Yuna-Celisse/light-control/docs/review-2026-11-10.md

# 2026-11-10 设计变更记录

以下为主控迁移前的历史 PCB 复核。此后用户要求清空全部布线与过孔，已保存并回读确认走线 0、过孔 0。历史 DRC 零违规结果对应此前板文件。当前原理图已迁移 STM32F103C8T6，PCB 已完成同步，待重新布线。

## PCB 同步与 SWD 焊盘

2026-11-10 将最新原理图同步至 PCB，按用户要求尽量保留原布局，并将 SWD 接口改为表面焊接焊盘。保存板含 164 个器件、102 个网络、3 个铺铜区，走线和过孔均为 0。

### 布局变更

155 个原器件的位置、角度和层逐项回读一致。U5 替换为 LQFP48，中心沿用 (90, 72) mm，角度设为 270°。删除 L2、L3、C36 及其残留丝印。Y1 回灌标准封装并沿用原位置与角度。为消除新主控封装碰撞，微调以下外围器件。

|器件|原位置 mm|最终位置 mm|
|---|---|---|
|R9|(84, 73.5)|(83.4, 73.5)|
|R12|(84, 75)|(83.4, 75)|
|C16|(93.5, 66.5)|(93.5, 64)|
|C17|(88.5, 77.5)|(88.5, 78.5)|
|C35|(95, 72)|(96.5, 72)|
|R36|(91.2, 77.5)|(91.2, 78.5)|
|R37|(92.4, 77.5)|(92.4, 78.5)|

J2 使用工程内封装 `Lights_Edge:SWD_SolderPads_1x06_P2.00mm`。六个焊盘位于正面，单焊盘 1.5 × 2 mm、中心间距 2 mm，焊盘 1 位于 (62, 64) mm，其余向右递增。只含 F.Cu 与 F.Mask，SWD 钻孔数为 0。正面从左至右为 3V3、SWDIO、GND、SWCLK、NRST、GND，已添加信号丝印和 pin 1 标记。

新焊盘通过 MCP 创建，已查询库内几何、导出并查看临时原理图及 PCB，核对编号方向、尺寸与零钻孔后用于工程。原理图的 J2 封装、器件值与 Y1 采购型号字段已同步。变更通过 Konnect MCP 与用户已允许的 KiCad 原生 IPC 完成。

### 最终验证

- 根原理图层级同步预检为 `noop`，零变更、零冲突，覆盖 11 张在用原理图。
- 实时 IPC 核对 164 个器件的引用、数值、封装一致，全部原理图引脚均有 PCB 焊盘，焊盘网络差异为 0。
- SWD 实例为 6 个 SMD 焊盘，钻孔尺寸均为 0。
- 重填铺铜、保存后运行 KiCad 10.0.8 DRC。253 项错误均为未布线连接，8 项警告包括 6 项 `lib_footprint_mismatch`、1 项 Y1 的 `C0 max` 字段差异、1 项 In1.Cu 地铜孤岛。
- 短路、铜间距、阻焊桥、封装碰撞、PTH 穿入封装及丝印违规均为 0。
- 原理图 ERC 为 0 个错误、27 个库符号差异警告。
- 布局评分为 85，圆角板框使该工具返回 `outline_unproven`，完整布局就绪结论仍缺该工具的包含性证明。

同步期间编辑器两次退出，已从保存检查点恢复并重新核对最终器件、网络和位置。原生 IPC 新增晶振自定义字段触发退出，PCB 的 `C0 max` 字段差异保留在报告中。Y1 的完整采购型号已写入原理图 MPN 与 PCB 器件值。当前板待重新布线。

检查报告与源文件哈希已更新。部分标准库仍使用本机其他工程的绝对路径。

## 原理图模块连线整理

2026-11-10 完成 11 张在用原理图整理。模块内部的电阻、电容、IC 与反馈回路改为连续导线，模块之间通过网络标签连接。电源与地使用电源符号，内部网名在需要说明节点时标注于连续导线上。

- 顶层 USB、VBUS 与主控之间长线改为接口标签。
- STM32 的复位、启动、晶振、USB 串联电阻与上拉、供电去耦改为直接连线，调试、按键与指示灯按功能分组。
- USB 插座到 ESD、CC 下拉和屏蔽 RC 直接连线。
- ADC 输入滤波、上拉电阻与供电去耦直接接入对应引脚支路。
- 双光谱模块的电平转换偏置、上拉、中断与去耦整理为连续电路。
- 双 TIA 与双恒流驱动的反馈电阻、补偿电容和 MOS 管直接连成闭环，参考电源与关断控制按功能成组。

独立导出网表核对了全部 164 个器件的型号、数值、封装、UUID 与层级路径，结果一致。整理前后 102 组网络端点集合一致，新增与删除的连接集合均为 0。逐页导线检查均为 0 个悬空端点，短路、孤立项、连接与层级端口检查均为 0 项。已查看全部在用页最终渲染图，并修正重叠标注与残留孤立连接点。

KiCad 10.0.8 独立 CLI ERC 为 0 个错误、27 个既有库符号差异警告，报告与源文件哈希已更新。当前检查对应此次整理后的原理图。

## STM32 原理图迁移

已将主控替换为 STM32F103C8T6，根页改为引用 `03_stm32f103.kicad_sch`。旧 ESP32 子页作为未引用历史文件保留。双 AS7341 承担系统中的其他检测用途，保留其 1.8 V 供电、PCA9306 与中断电平转换，同时保留 ADS1115、双 TIA、双波长驱动和 USB。

- 移除 ESP32 专用 L2、L3、C36，新增 J2 SWD 接口，复用其他外围器件。
- 补齐三组 VDD 100 nF、10 µF 总旁路、VBAT 100 nF、VDDA 100 nF 与 1 µF。
- NRST 使用 10 kΩ 上拉与 100 nF，BOOT0 与 BOOT1 下拉，BOOT 按键拉高 BOOT0。
- USB 使用 PA11/PA12、22 Ω 串联电阻和 MCU 侧 D+ 1.5 kΩ 上拉。
- PB6/PB7 连接 ADS1115 与左 AS7341，PB10/PB11 连接右 AS7341。中断使用不同 EXTI 编号。
- 选择 ABM8W-12.0000MHZ-6-D1X-T3，HSE 12 MHz、PLL ×6、USB 分频 1.5。C38/C39 初配 6 pF，寄生暂按 3 pF 估计，实际负载、驱动功率与起振须在最终 PCB 上验证。

### 当前验证

KiCad 10.0.8 独立 CLI ERC 覆盖 11 张在用原理图，结果为 0 个错误、27 个警告，全部为 `lib_symbol_mismatch`。MCP 更新库符号后仍返回未变更，这些差异告警保留，详细结果位于 `docs/checks/erc.json`。

导出网表为 164 个器件。独立检查确认 U5 的 VBAT、VDDA、三个 VDD 与四个地引脚连接正确，USB 上拉在 MCU 侧，两组 I²C 端点正确。迁移前后比较主控块以外全部端点的连接集合，业务模块间连接一致。主控连接、短路、孤立项、重叠与层级端口检查均为 0 项，已查看主控页和根页渲染图。

新注册的部分标准符号与封装库仍引用 `/home/yunacelisse/rocos-transmitter/rocos-transmitter/libraries/` 的本机绝对路径，迁移环境时需要配置相应标准库。源文件哈希已更新。`docs/checks/drc.json` 已更新为当前 PCB 检查结果，后续布线完成后需再次验证。

### 原厂依据

- 主控供电、引脚、USB 与 HSE 参数见 [ST STM32F103x8/xB 数据手册](https://www.st.com/resource/en/datasheet/stm32f103c8.pdf)。
- 主控外围设计见 [ST AN2586 硬件开发指南](https://www.st.com/resource/en/application_note/an2586-getting-started-with-stm32f10xxx-hardware-development-stmicroelectronics.pdf)。
- 晶振电气参数与焊盘定义见 [Abracon ABM8W 数据手册](https://abracon.com/datasheets/ABM8W.pdf)。

## 历史 PCB 复核

2026-11-10，目标为工作区 light-control.kicad_pcb，裸芯片 ESP32-S3FN8 四层板。全部源设计变更经 Konnect MCP 实时 IPC 完成。本记录描述已保存源文件。

## 已完成修复

1. 晶振 Y1 下方的 In2.Cu VBUS_DET 原斜线穿过晶振投影，已改为沿晶振上方与左侧绕行。时钟输入输出保持顶层，无新增时钟过孔。首次候选产生的铜冲突已在后续迭代消除。EN_760、EN_850 精确线段几何复核后未穿过晶振本体，恢复原路径。
2. U2 降压电源 C6 100nF 的 VIN 支路由经 C5 焊盘绕行改为直接到 U2 VIN。新支路使用 0.3mm 线宽。电容位置保持原坐标。
3. U101短距TIA输出反馈支路已缩短，增加两颗过孔，负输入节点保持原状。
4. 经 IPC 重填全部铺铜，再保存。随后以保存文件运行完整 KiCad DRC。

## 模块检查

|模块|本次证据与判断|
|---|---|
|晶振与ESP32|修复本体下方VBUS_DET。晶振40MHz、负载电容两颗15pF，标称CL10pF，精确负载和频偏仍须结合具体晶体MPN、寄生及实测。芯片与晶振间距应按乐鑫裸芯片指南处理。|
|降压电源|SW顶层三段0.5mm，总长约3.02mm。FB位于另一侧。缩短C6高频供电支路，输入输出环路仍需实测纹波和负载瞬态。|
|1.8V与光谱传感器|检查相关IC与电容现有位置、供电连接。自动审查中跨页电源缺电容的告警须结合整个层次网表判断。|
|USB与ESD|顶层主干0.25mm线宽、0.4mm中心距，主体成对经过USBLC6。90Ω差分阻抗仍缺板厂实际叠层验证。|
|ADS1115|VDD到C22正端直线约2.4mm。检查了器件位置和网络。有效精度、输入滤波带宽仍需实测验证。|
|双路TIA|U101/C105、U102/C110电源引脚到100nF正端均约1.7mm。U101输出反馈绕行约14mm，显著优化涉及局部反馈/参考/接地协调处理。已通过两颗0.6/0.3mm过孔，让低阻输出侧在In2.Cu回接R102，三段0.2mm走线合计5.754mm。负输入SUM保持原布局和走线。最终DRC零违规。|
|LED驱动与参考电源|执行全层次ERC和聚合连接、电源审查，相关模拟性能、驱动电流及温升尚无实测证据。|
|板框与装配|DRC无板框或courtyard错误。布局评分器对圆角板框返回outline_unproven，100分不能作为完整通过证据。R39与U102分处正反面，不能用二维中心距离直接判定同面装配冲突。|

## 验证结果

- 实时IPC板信息确认4层、115网络、166器件。查询并保存最终走线证据 本次 IPC 回读记录（本地）。
- checks/drc.json 为铺铜实时重填并保存后的KiCad检查，0 errors、0 warnings、0 unconnected、0 schematic parity。
- checks/erc.json，KiCad 10.0.7，0 errors、0 warnings。
- 本地聚合复核报告覆盖11个原理图文件、11个sheet实例。聚合报告的电源告警含跨页遗漏与将VBUS_DET检测信号当电源的启发式项，未盲目增加器件。
- 自动检查与当前几何证据不足以证明噪声、晶振起振裕量、USB阻抗及实板性能满足指标。整体电气设计审查仍有待完成项。

## 原厂依据

- https://docs.espressif.com/projects/esp-hardware-design-guidelines/en/latest/esp32s3/pcb-layout-design.html
- https://www.ti.com/lit/ds/symlink/tlv62568.pdf
- https://www.ti.com/lit/ds/symlink/tlv9061.pdf

## 界面差异与后续任务

用户随后提供的编辑器截图显示1467条走线与166个过孔。再次IPC回读得到1470条走线，保存文件中有168个过孔与U101新增输出反馈路径。重绘尝试后截图仍未更新，显示差异原因尚未确定。晶振周围器件位置未作调整，布局和地隔离审查仍需继续。

本次发布前对保存文件重新检查，DRC与ERC均零错误、零警告。
