Yuna-Celisse/light-control/BOM/20261029/light-control-BOM-detail.csv

Reference | Value | Footprint | Quantity | Manufacturer | MPN | Tolerance | Dielectric | ProcurementStatus | Datasheet | DNP | ExcludeFromBOM | ExcludeFromBoard
C1 | 1uF_16V | Capacitor_SMD:C_0603_1608Metric | 1
C2 | 0.1uF | Capacitor_SMD:C_0402_1005Metric | 1
C3 | 10nF | Capacitor_SMD:C_0402_1005Metric | 1
C4 | 10nF | Capacitor_SMD:C_0603_1608Metric | 1
C5 | 4.7uF_16V | Capacitor_SMD:C_0805_2012Metric | 1
C6 | 0.1uF | Capacitor_SMD:C_0402_1005Metric | 1
C7 | 22uF_10V | Capacitor_SMD:C_0805_2012Metric | 1
C8 | 0.1uF | Capacitor_SMD:C_0402_1005Metric | 1
C9 | 1uF | Capacitor_SMD:C_0402_1005Metric | 1
C10 | 2.2uF | Capacitor_SMD:C_0603_1608Metric | 1
C11 | 0.1uF | Capacitor_SMD:C_0402_1005Metric | 1
C12 | 1uF_16V | Capacitor_SMD:C_0402_1005Metric | 1
C14 | 4.7uF | Capacitor_SMD:C_0603_1608Metric | 1
C15 | 10uF | Capacitor_SMD:C_0805_2012Metric | 1
C16 | 100nF | Capacitor_SMD:C_0402_1005Metric | 1
C17 | 100nF | Capacitor_SMD:C_0402_1005Metric | 1
C18 | 1uF | Capacitor_SMD:C_0402_1005Metric | 1
C19 | 1nF | Capacitor_SMD:C_0402_1005Metric | 1
C20 | 1nF | Capacitor_SMD:C_0402_1005Metric | 1
C21 | 1nF | Capacitor_SMD:C_0402_1005Metric | 1
C22 | 0.1uF | Capacitor_SMD:C_0402_1005Metric | 1
C23 | 10uF | Capacitor_SMD:C_0805_2012Metric | 1
C24 | 0.1uF | Capacitor_SMD:C_0402_1005Metric | 1
C25 | 0.1uF | Capacitor_SMD:C_0402_1005Metric | 1
C26 | 1uF | Capacitor_SMD:C_0402_1005Metric | 1
C27 | 0.1uF | Capacitor_SMD:C_0402_1005Metric | 1
C28 | 0.1uF | Capacitor_SMD:C_0402_1005Metric | 1
C29 | 0.1uF | Capacitor_SMD:C_0402_1005Metric | 1
C30 | 1uF | Capacitor_SMD:C_0402_1005Metric | 1
C31 | 0.1uF | Capacitor_SMD:C_0402_1005Metric | 1
C32 | 6.8pF | Capacitor_SMD:C_0402_1005Metric | 1 |  |  | 5% | C0G
C33 | 100nF | Capacitor_SMD:C_0402_1005Metric | 1
C34 | 1uF | Capacitor_SMD:C_0402_1005Metric | 1
C35 | 100nF | Capacitor_SMD:C_0402_1005Metric | 1
C36 | 1uF | Capacitor_SMD:C_0402_1005Metric | 1
C37 | 100nF | Capacitor_SMD:C_0402_1005Metric | 1
C38 | 15pF C0G | Capacitor_SMD:C_0402_1005Metric | 1
C39 | 15pF C0G | Capacitor_SMD:C_0402_1005Metric | 1
C101 | 10uF | Capacitor_SMD:C_0805_2012Metric | 1 |  | CL21A106KAYNNNE
C102 | 10pF | Capacitor_SMD:C_0603_1608Metric | 1 | SAMSUNG(三星) | CL10C100JB8NNNC
C103 | 10uF | Capacitor_SMD:C_0805_2012Metric | 1 |  | CL21A106KAYNNNE
C104 | 1uF | Capacitor_SMD:C_0603_1608Metric | 1 | SAMSUNG(三星) | CL10A105KB8NNNC
C105 | 100nF | Capacitor_SMD:C_0603_1608Metric | 1 | YAGEO(国巨) | CC0603KRX7R9BB104
C106 | 10nF | Capacitor_SMD:C_0603_1608Metric | 1 | FH(风华) | 0603B103K500NT
C107 | 1.5pF | Capacitor_SMD:C_0603_1608Metric | 1 | SAMSUNG(三星) | CL10C1R5BB8NNNC
C108 | 10uF | Capacitor_SMD:C_0805_2012Metric | 1 |  | CL21A106KAYNNNE
C109 | 1uF | Capacitor_SMD:C_0603_1608Metric | 1 | SAMSUNG(三星) | CL10A105KB8NNNC
C110 | 100nF | Capacitor_SMD:C_0603_1608Metric | 1 | YAGEO(国巨) | CC0603KRX7R9BB104
C111 | 10nF | Capacitor_SMD:C_0603_1608Metric | 1 | FH(风华) | 0603B103K500NT
C112 | 10uF | Capacitor_SMD:C_0805_2012Metric | 1 |  | CL21A106KAYNNNE
C113 | 10uF | Capacitor_SMD:C_0805_2012Metric | 1 |  | CL21A106KAYNNNE
C114 | 1uF | Capacitor_SMD:C_0603_1608Metric | 1 | SAMSUNG(三星) | CL10A105KB8NNNC
C115 | 100nF | Capacitor_SMD:C_0603_1608Metric | 1 | SAMSUNG(三星) | CL10B104KB8NNNC
C116 | 1nF | Capacitor_SMD:C_0603_1608Metric | 1 | SAMSUNG(三星) | CL10C102JB8NNNC
C117 | 1nF | Capacitor_SMD:C_0603_1608Metric | 1 | SAMSUNG(三星) | CL10C102JB8NNNC
C118 | 100nF | Capacitor_SMD:C_0603_1608Metric | 1
C119 | 1uF | Capacitor_SMD:C_0603_1608Metric | 1
D1 | LED_STATE | LED_SMD:LED_0603_1608Metric | 1
D101 | 760-770nm | FNIRS:JNJ_760_3535_3P | 1 | JNJOPTO(强生光电) | JNJ-LEHR0113W120/42MIL/760-770NM
D102 | VBPW34S | FNIRS:VBPW34S_Normal_Gullwing | 1 | VISHAY(威世) | VBPW34S
D103 | VBPW34S | FNIRS:VBPW34S_Normal_Gullwing | 1 | VISHAY(威世) | VBPW34S
D104 | 850nm | FNIRS:JNJ_850_3036_2P | 1 | JNJOPTO(强生光电) | JNJ-LTJI0106W90/14mil-D/850NM
H1 | M3_NPTH_3.2mm | Lights_Edge:MountingHole_M3_3.2mm_Clearance7mm | 1
H2 | M3_NPTH_3.2mm | Lights_Edge:MountingHole_M3_3.2mm_Clearance7mm | 1
H3 | M3_NPTH_3.2mm | Lights_Edge:MountingHole_M3_3.2mm_Clearance7mm | 1
H4 | M3_NPTH_3.2mm | Lights_Edge:MountingHole_M3_3.2mm_Clearance7mm | 1
J1 | USB-C_16P | Lights_Edge:USB_C_Receptacle_HRO_TYPE-C-31-M-12 | 1 |  |  |  |  |  | https://www.usb.org/sites/default/files/documents/usb_type-c.zip
L1 | XAL4020-222MEC | Inductor_SMD:L_Coilcraft_XAL4020-XXX | 1
L2 | 2nH 600mA | Inductor_SMD:L_0402_1005Metric | 1
L3 | 24nH | Inductor_SMD:L_0402_1005Metric | 1
Q1 | DMN2056U-7 | Package_TO_SOT_SMD:SOT-23 | 1 | Diodes Incorporated | DMN2056U-7 |  |  |  | https://www.diodes.com/assets/Datasheets/DMN2056U.pdf
Q2 | DMN2056U-7 | Package_TO_SOT_SMD:SOT-23 | 1 | Diodes Incorporated | DMN2056U-7 |  |  |  | https://www.diodes.com/assets/Datasheets/DMN2056U.pdf
Q3 | DMN2056U-7 | Package_TO_SOT_SMD:SOT-23 | 1 | Diodes Incorporated | DMN2056U-7 |  |  |  | https://www.diodes.com/assets/Datasheets/DMN2056U.pdf
Q4 | DMN2056U-7 | Package_TO_SOT_SMD:SOT-23 | 1 | Diodes Incorporated | DMN2056U-7 |  |  |  | https://www.diodes.com/assets/Datasheets/DMN2056U.pdf
Q101 | AO3400A | Package_TO_SOT_SMD:SOT-23 | 1 | Alpha and Omega Semiconductor | AO3400A |  |  |  | http://www.aosmd.com/pdfs/datasheet/AO3400A.pdf
Q102 | AO3400A | Package_TO_SOT_SMD:SOT-23 | 1 | Alpha and Omega Semiconductor | AO3400A |  |  |  | http://www.aosmd.com/pdfs/datasheet/AO3400A.pdf
Q103 | 2N7002 | Package_TO_SOT_SMD:SOT-23 | 1 | Vishay | 2N7002 |  |  |  | https://www.onsemi.com/pub/Collateral/NDS7002A-D.PDF
Q104 | 2N7002 | Package_TO_SOT_SMD:SOT-23 | 1 | Vishay | 2N7002 |  |  |  | https://www.onsemi.com/pub/Collateral/NDS7002A-D.PDF
R1 | 5.1k | Resistor_SMD:R_0402_1005Metric | 1
R2 | 5.1k | Resistor_SMD:R_0402_1005Metric | 1
R3 | 100k | Resistor_SMD:R_0402_1005Metric | 1
R4 | 150k | Resistor_SMD:R_0402_1005Metric | 1
R5 | 1M | Resistor_SMD:R_0603_1608Metric | 1
R6 | 453k | Resistor_SMD:R_0402_1005Metric | 1
R7 | 100k | Resistor_SMD:R_0402_1005Metric | 1
R8 | 100k | Resistor_SMD:R_0402_1005Metric | 1
R9 | 10k | Resistor_SMD:R_0402_1005Metric | 1
R10 | 1k | Resistor_SMD:R_0402_1005Metric | 1
R11 | 10k | Resistor_SMD:R_0402_1005Metric | 1
R12 | 10k | Resistor_SMD:R_0402_1005Metric | 1
R13 | 100k | Resistor_SMD:R_0402_1005Metric | 1
R14 | 100k | Resistor_SMD:R_0402_1005Metric | 1
R15 | 100 | Resistor_SMD:R_0402_1005Metric | 1
R16 | 100 | Resistor_SMD:R_0402_1005Metric | 1
R17 | 100 | Resistor_SMD:R_0402_1005Metric | 1
R18 | 10k | Resistor_SMD:R_0402_1005Metric | 1
R19 | 4.7k | Resistor_SMD:R_0402_1005Metric | 1
R20 | 4.7k | Resistor_SMD:R_0402_1005Metric | 1
R21 | 4.7k | Resistor_SMD:R_0402_1005Metric | 1
R22 | 4.7k | Resistor_SMD:R_0402_1005Metric | 1
R23 | 4.7k | Resistor_SMD:R_0402_1005Metric | 1
R24 | 4.7k | Resistor_SMD:R_0402_1005Metric | 1
R25 | 200k | Resistor_SMD:R_0402_1005Metric | 1 |  |  | 1%
R26 | 10k | Resistor_SMD:R_0402_1005Metric | 1
R27 | 10k | Resistor_SMD:R_0402_1005Metric | 1
R29 | 4.7k | Resistor_SMD:R_0402_1005Metric | 1
R30 | 4.7k | Resistor_SMD:R_0402_1005Metric | 1
R31 | 4.7k | Resistor_SMD:R_0402_1005Metric | 1
R32 | 4.7k | Resistor_SMD:R_0402_1005Metric | 1
R33 | 200k | Resistor_SMD:R_0402_1005Metric | 1 |  |  | 1%
R34 | 10k | Resistor_SMD:R_0402_1005Metric | 1
R35 | 10k | Resistor_SMD:R_0402_1005Metric | 1
R36 | 22 | Resistor_SMD:R_0402_1005Metric | 1
R37 | 22 | Resistor_SMD:R_0402_1005Metric | 1
R38 | 68k | Resistor_SMD:R_0402_1005Metric | 1 |  |  | 1%
R39 | 133k | Resistor_SMD:R_0402_1005Metric | 1 |  |  | 1%
R40 | 100k | Resistor_SMD:R_0402_1005Metric | 1
R41 | 10k | Resistor_SMD:R_0402_1005Metric | 1
R42 | 10k | Resistor_SMD:R_0402_1005Metric | 1
R102 | 1M | Resistor_SMD:R_0603_1608Metric | 1 | UNI-ROYAL(厚声) | 0603WAF1004T5E
R103 | 100 | Resistor_SMD:R_0603_1608Metric | 1 | UNI-ROYAL(厚声) | 0603WAF1000T5E
R104 | 100 | Resistor_SMD:R_0603_1608Metric | 1 | UNI-ROYAL(厚声) | 0603WAF1000T5E
R105 | 100 | Resistor_SMD:R_0603_1608Metric | 1 | UNI-ROYAL(厚声) | 0603WAF1000T5E
R106 | 10M | Resistor_SMD:R_0603_1608Metric | 1 | UNI-ROYAL(厚声) | 0603WAF1005T5E
R107 | 100 | Resistor_SMD:R_0603_1608Metric | 1 | UNI-ROYAL(厚声) | 0603WAF1000T5E
R108 | 100 | Resistor_SMD:R_0603_1608Metric | 1 | UNI-ROYAL(厚声) | 0603WAF1000T5E
R109 | 100 | Resistor_SMD:R_0603_1608Metric | 1 | UNI-ROYAL(厚声) | 0603WAF1000T5E
R110 | 3.9k | Resistor_SMD:R_0603_1608Metric | 1 | UNI-ROYAL(厚声) | 0603WAF3901T5E
R111 | 4.7k | Resistor_SMD:R_0603_1608Metric | 1 | UNI-ROYAL(厚声) | 0603WAF4701T5E
R112 | 20k | Resistor_SMD:R_0603_1608Metric | 1 | UNI-ROYAL(厚声) | 0603WAF2002T5E
R113 | 39k | Resistor_SMD:R_0603_1608Metric | 1 | UNI-ROYAL(厚声) | 0603WAF3902T5E
R114 | 10k | Resistor_SMD:R_0603_1608Metric | 1 | UNI-ROYAL(厚声) | 0603WAF1002T5E
R115 | 39k | Resistor_SMD:R_0603_1608Metric | 1 | UNI-ROYAL(厚声) | 0603WAF3902T5E
R116 | 10k | Resistor_SMD:R_0603_1608Metric | 1 | UNI-ROYAL(厚声) | 0603WAF1002T5E
R117 | 1k | Resistor_SMD:R_0603_1608Metric | 1 | UNI-ROYAL(厚声) | 0603WAF1001T5E
R118 | 100k | Resistor_SMD:R_0603_1608Metric | 1 | UNI-ROYAL(厚声) | 0603WAF1003T5E
R119 | 1k | Resistor_SMD:R_0603_1608Metric | 1 | UNI-ROYAL(厚声) | 0603WAF1001T5E
R120 | 100k | Resistor_SMD:R_0603_1608Metric | 1 | UNI-ROYAL(厚声) | 0603WAF1003T5E
R121 | 100 | Resistor_SMD:R_0603_1608Metric | 1 | UNI-ROYAL(厚声) | 0603WAF1000T5E
R122 | 10 | Resistor_SMD:R_0603_1608Metric | 1 | UNI-ROYAL(厚声) | 0603WAF100JT5E
R123 | 100 | Resistor_SMD:R_0603_1608Metric | 1 | UNI-ROYAL(厚声) | 0603WAF1000T5E
R124 | 10 | Resistor_SMD:R_0603_1608Metric | 1 | UNI-ROYAL(厚声) | 0603WAF100JT5E
R125 | 1k | Resistor_SMD:R_0603_1608Metric | 1 | UNI-ROYAL(厚声) | 0603WAF1001T5E
R126 | 1k | Resistor_SMD:R_0603_1608Metric | 1 | UNI-ROYAL(厚声) | 0603WAF1001T5E
SW1 | RESET | Button_Switch_SMD:SW_SPST_PTS645Sx43SMTR92 | 1
SW2 | USER_KEY | Button_Switch_SMD:SW_SPST_PTS645Sx43SMTR92 | 1
SW3 | BOOT | Button_Switch_SMD:SW_SPST_PTS645Sx43SMTR92 | 1
TP1 | TP_RXD0 | TestPoint:TestPoint_Pad_D1.0mm | 1
TP2 | TP_TXD0 | TestPoint:TestPoint_Pad_D1.0mm | 1
TP3 | PROBE_FAULT_N | TestPoint:TestPoint_Pad_D1.0mm | 1
U1 | USBLC6-2SC6 | Package_TO_SOT_SMD:SOT-23-6 | 1 | STMicroelectronics | USBLC6-2SC6 |  |  |  | https://www.st.com/resource/en/datasheet/usblc6-2.pdf
U2 | TLV62568DBV | Package_TO_SOT_SMD:SOT-23-5 | 1 | Texas Instruments | TLV62568DBVR |  |  |  | http://www.ti.com/lit/ds/symlink/tlv62568.pdf
U3 | ME6211C18M5 | Package_TO_SOT_SMD:SOT-23-5 | 1 |  | ME6211C18M5 |  |  | Confirm packaging suffix and approved supplier before release | https://www.lcsc.com/datasheet/lcsc_datasheet_2304140030_MICRONE-Nanjing-Micro-One-Elec-ME6211C33R5G_C235316.pdf
U4 | TPS2553DBVR-1 | Package_TO_SOT_SMD:SOT-23-6 | 1 | Texas Instruments | TPS2553DBVR-1 |  |  |  | https://www.ti.com/lit/ds/symlink/tps2553.pdf
U5 | ESP32-S3FN8 | Package_DFN_QFN:QFN-56-1EP_7x7mm_P0.4mm_EP4x4mm | 1 | Espressif Systems | ESP32-S3FN8 |  |  |  | https://www.espressif.com/sites/default/files/documentation/esp32-s3_datasheet_en.pdf
U6 | ADS1115IDGS | Package_SO:TSSOP-10_3x3mm_P0.5mm | 1 | Texas Instruments | ADS1115IDGS |  |  | Confirm packaging suffix and approved supplier before release | http://www.ti.com/lit/ds/symlink/ads1113.pdf
U7 | PCA9306DCUR | Package_SO:VSSOP-8_2.3x2mm_P0.5mm | 1 | Texas Instruments | PCA9306DCUR |  |  |  | https://www.ti.com/lit/ds/symlink/pca9306.pdf
U8 | AS7341-DLGT | Package_LGA:AMS_OLGA-8_2x3.1mm_P0.8mm | 1 | ams OSRAM | AS7341-DLGT |  |  |  | https://ams.com/documents/20143/36005/AS7341_DS000504_3-00.pdf
U9 | PCA9306DCUR | Package_SO:VSSOP-8_2.3x2mm_P0.5mm | 1 | Texas Instruments | PCA9306DCUR |  |  |  | https://www.ti.com/lit/ds/symlink/pca9306.pdf
U10 | AS7341-DLGT | Package_LGA:AMS_OLGA-8_2x3.1mm_P0.8mm | 1 | ams OSRAM | AS7341-DLGT |  |  |  | https://ams.com/documents/20143/36005/AS7341_DS000504_3-00.pdf
U101 | TLV9061IDBVR | Package_TO_SOT_SMD:SOT-23-5 | 1 | TI(德州仪器) | TLV9061IDBVR |  |  |  | https://www.ti.com/lit/ds/symlink/tlv9061.pdf
U102 | TLV9061IDBVR | Package_TO_SOT_SMD:SOT-23-5 | 1 | TI(德州仪器) | TLV9061IDBVR |  |  |  | https://www.ti.com/lit/ds/symlink/tlv9061.pdf
U103 | ME6211C33M5G-N | Package_TO_SOT_SMD:SOT-23-5 | 1 | MICRONE(南京微盟) | ME6211C33M5G-N |  |  |  | https://www.lcsc.com/datasheet/lcsc_datasheet_2304140030_MICRONE-Nanjing-Micro-One-Elec-ME6211C33R5G_C235316.pdf
U104 | TLV431BIDBZR | Package_TO_SOT_SMD:SOT-23 | 1 | TI(德州仪器) | TLV431BIDBZR |  |  |  | https://www.ti.com/lit/ds/symlink/tlv431.pdf
U105 | TLV9062IDGKR | Package_SO:VSSOP-8_3x3mm_P0.65mm | 1 | TI(德州仪器) | TLV9062IDGKR |  |  |  | https://www.ti.com/lit/ds/symlink/tlv9062.pdf
Y1 | 40MHz CL10pF | Crystal:Crystal_SMD_3225-4Pin_3.2x2.5mm | 1 | Abracon | ABM8-40.000MHZ-10-1-U-T
