Yuna-Celisse/light-control/light-control.kicad_pcb

## KiCad design light-control.kicad_pcb (2026-11-10)

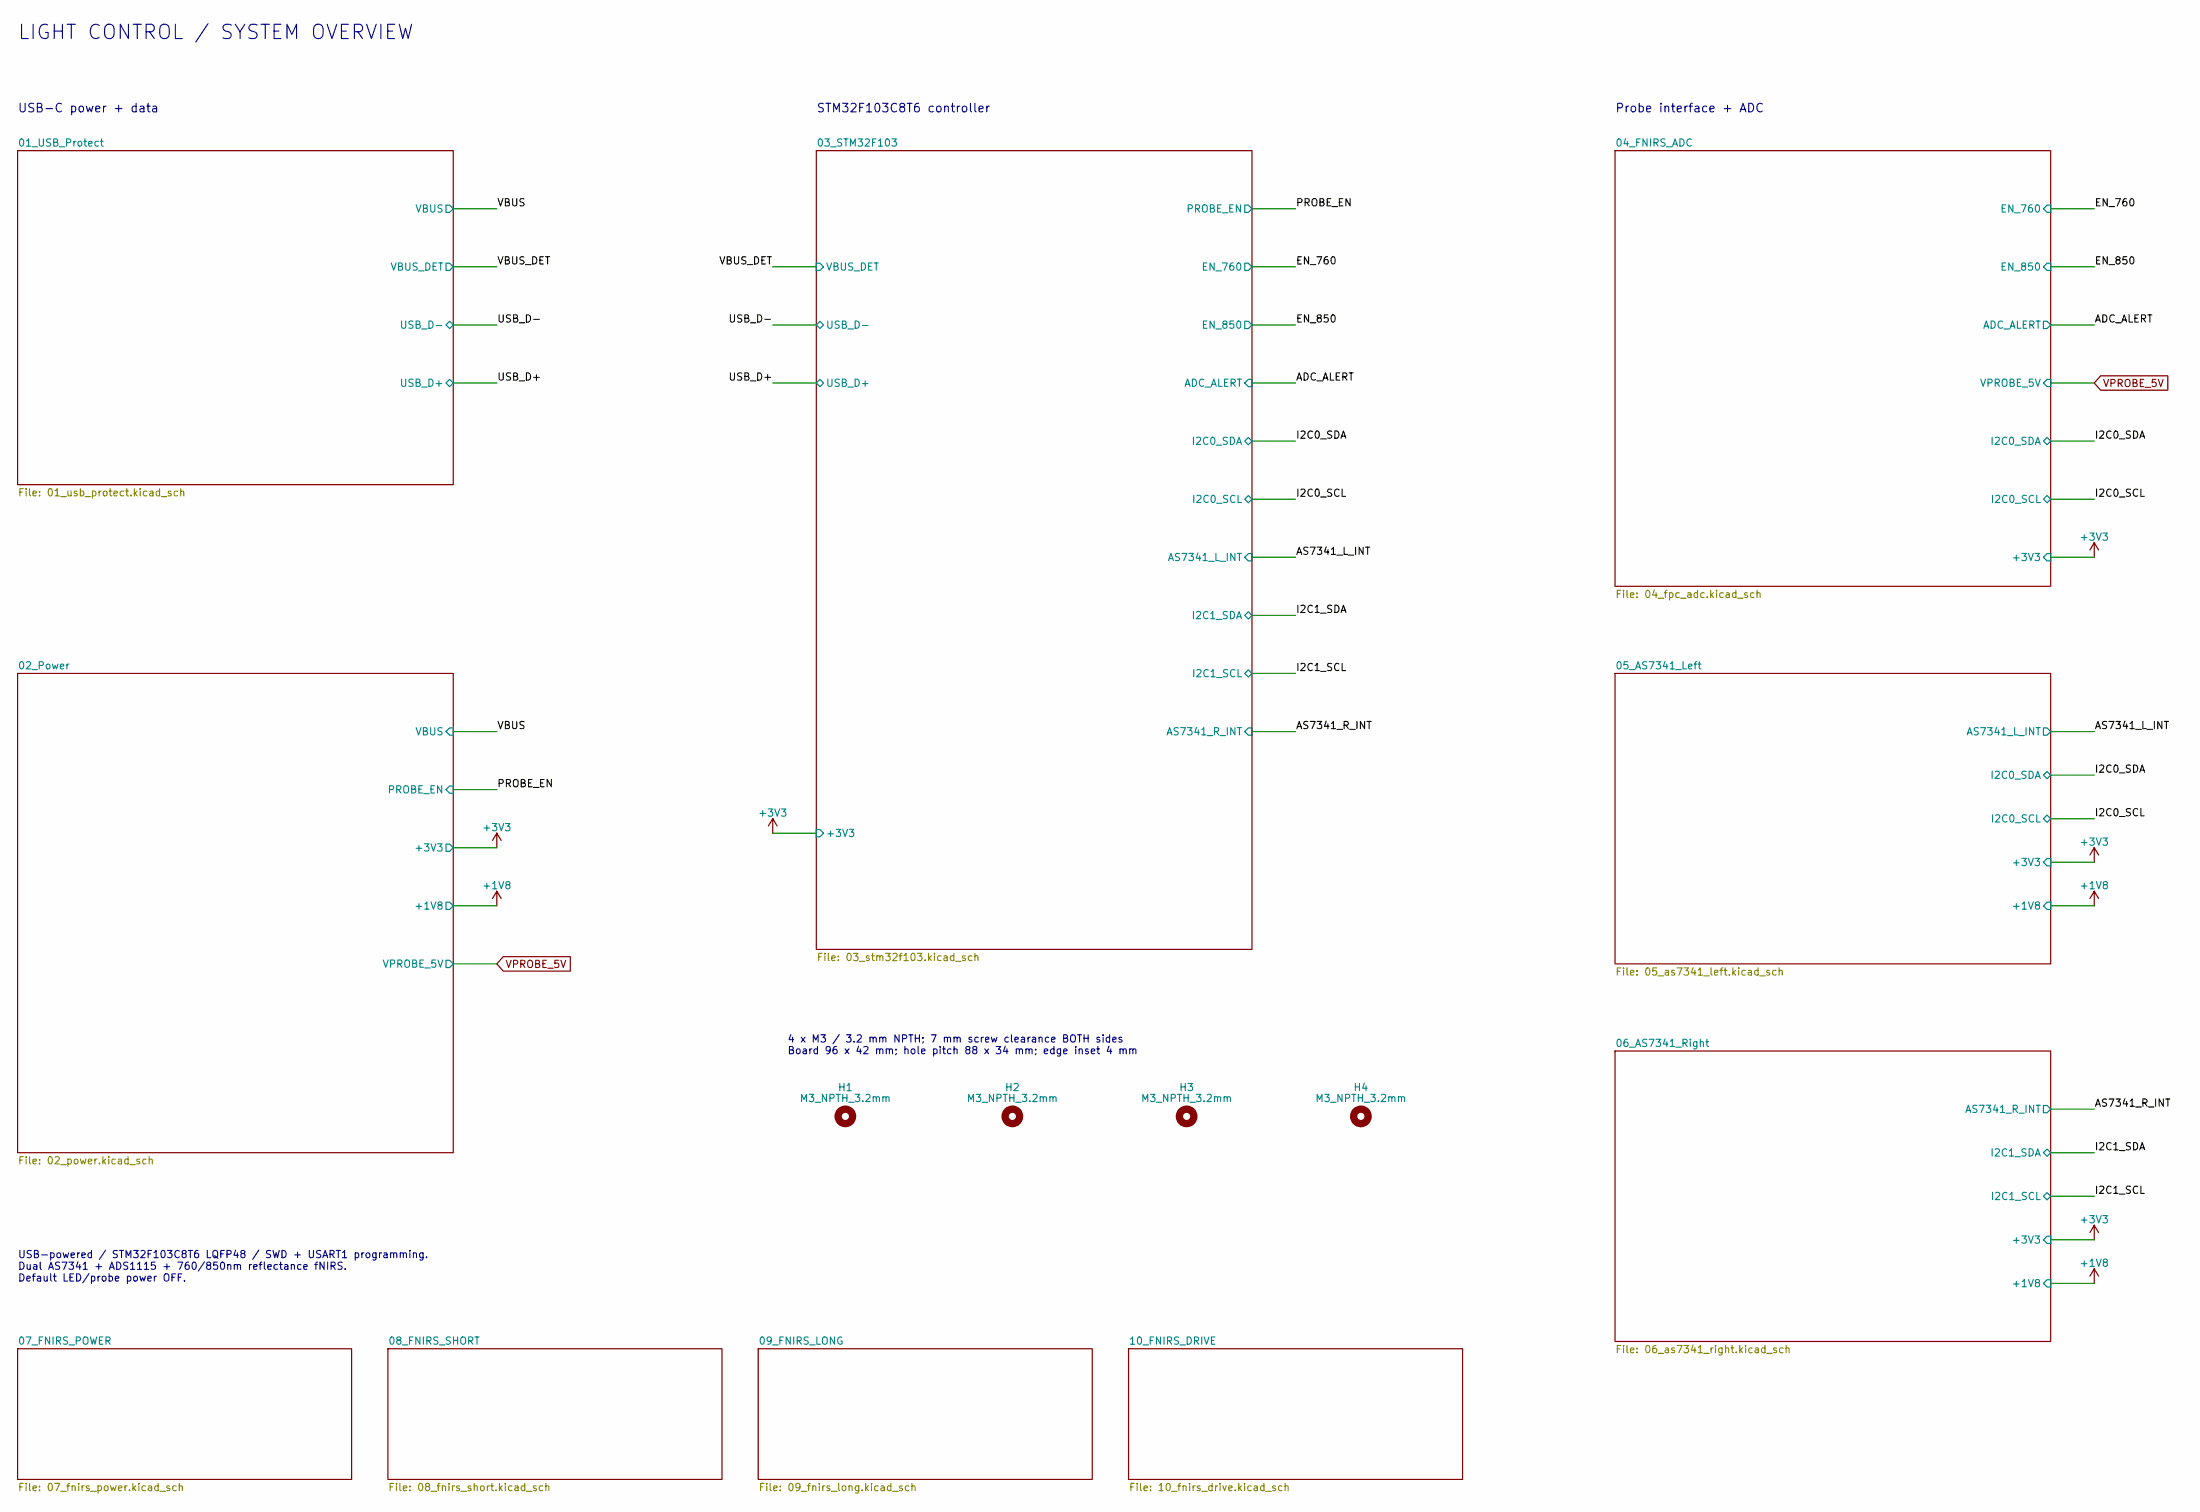
[picture p1: schematic light-control.kicad_sch]

Parts:
H1, H2, H3, H4: M3_NPTH_3.2mm; MountingHole_M3_3.2mm_Clearance7mm

Notes on the sheet:
LIGHT CONTROL / SYSTEM OVERVIEW
4 x M3 / 3.2 mm NPTH; 7 mm screw clearance BOTH sides Board 96 x 42 mm; hole pitch 88 x 34 mm; edge inset 4 mm
Probe interface + ADC
USB-C power + data
STM32F103C8T6 controller
USB-powered / STM32F103C8T6 LQFP48 / SWD + USART1 programming. Dual AS7341 + ADS1115 + 760/850nm reflectance fNIRS. Default LED/probe power OFF.

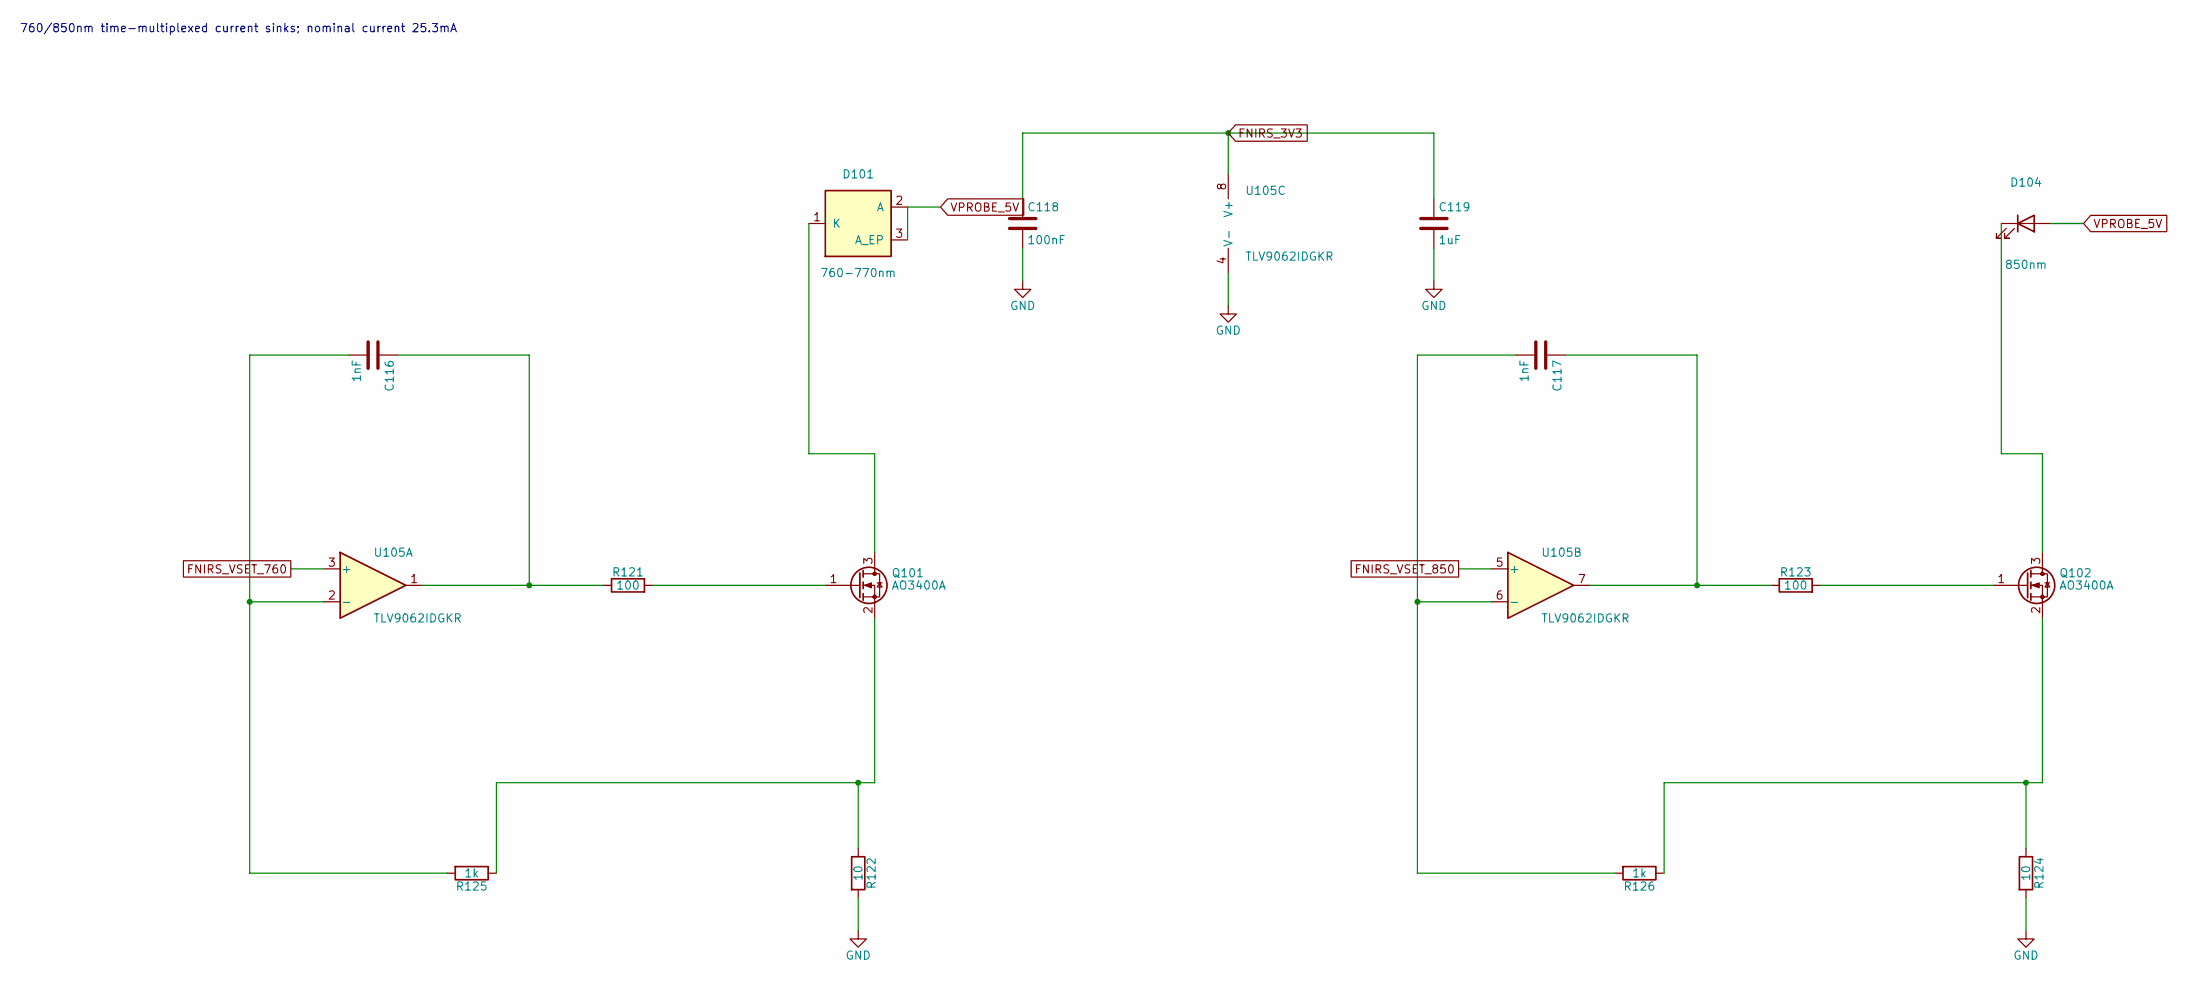
[picture p2: schematic 10_fnirs_drive.kicad_sch]

Parts:
C116, C117: 1nF; C_0603_1608Metric; MPN CL10C102JB8NNNC
C118: 100nF; C_0603_1608Metric
C119: 1uF; C_0603_1608Metric
D101: 760-770nm; JNJ_760_3535_3P; MPN JNJ-LEHR0113W120/42MIL/760-770NM
D104: 850nm; JNJ_850_3036_2P; MPN JNJ-LTJI0106W90/14mil-D/850NM
Q101, Q102: AO3400A; SOT-23; MPN AO3400A
R121, R123: 100; R_0603_1608Metric; MPN 0603WAF1000T5E
R122, R124: 10; R_0603_1608Metric; MPN 0603WAF100JT5E
R125, R126: 1k; R_0603_1608Metric; MPN 0603WAF1001T5E
U105: TLV9062IDGKR; VSSOP-8_3x3mm_P0.65mm; MPN TLV9062IDGKR

Connections:
FNIRS_3V3: C118.1, C119.1, U105.8 (V+); also elsewhere on the board
FNIRS_VSET_760: U105.3 (+); also elsewhere on the board
FNIRS_VSET_850: U105.5 (+); also elsewhere on the board
unnamed: C116.1, R121.1, U105.1
unnamed: C117.1, R123.1, U105.7
unnamed: D101.1 (K), Q101.3 (D)
unnamed: D104.1 (K), Q102.3 (D)
unnamed: Q101.1 (G), R121.2
unnamed: Q101.2 (S), R122.1, R125.1
unnamed: Q102.1 (G), R123.2
unnamed: Q102.2 (S), R124.1, R126.1
unnamed: C116.2, R125.2, U105.2 (-)
unnamed: C117.2, R126.2, U105.6 (-)
VPROBE_5V: D101.2 (A), D101.3 (A_EP), D104.2 (A); also elsewhere on the board

Notes on the sheet:
760/850nm time-multiplexed current sinks; nominal current 25.3mA

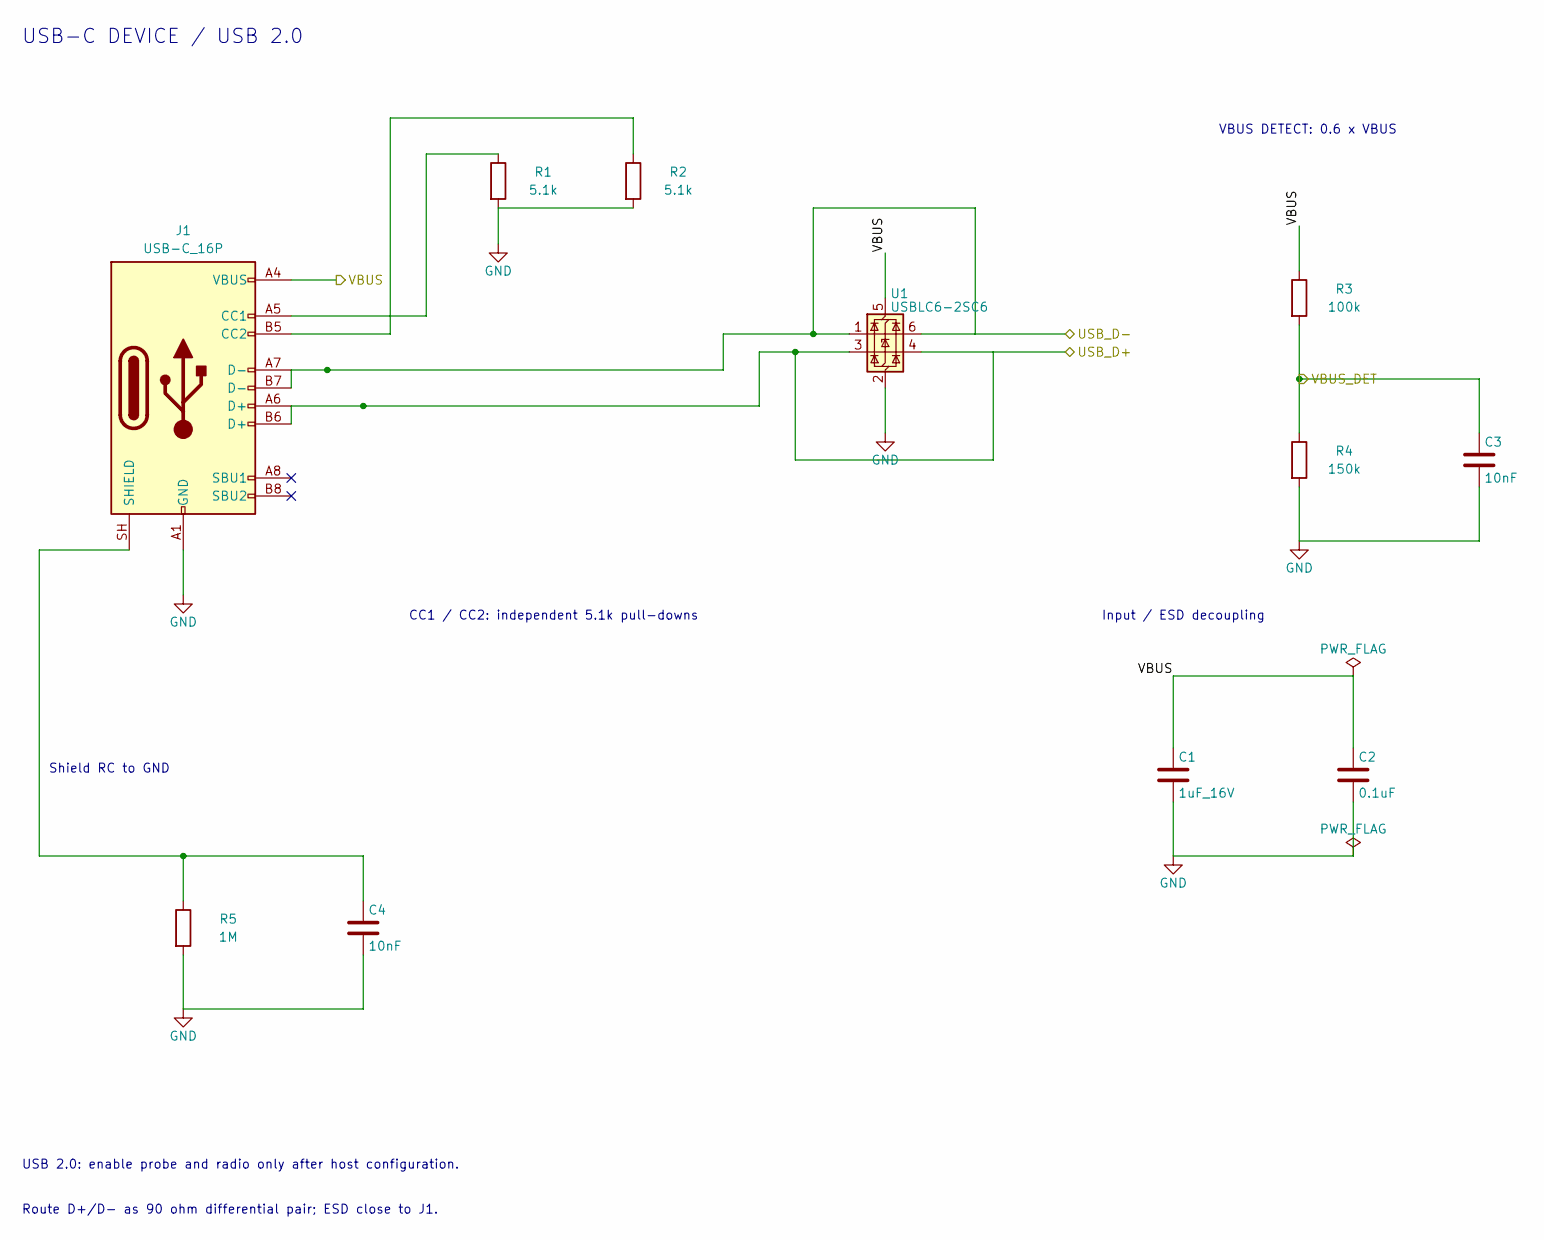
[picture p3: schematic 01_usb_protect.kicad_sch]

Parts:
C1: 1uF_16V; C_0603_1608Metric
C2: 0.1uF; C_0402_1005Metric
C3: 10nF; C_0402_1005Metric
C4: 10nF; C_0603_1608Metric
J1: USB-C_16P; USB_C_Receptacle_HRO_TYPE-C-31-M-12
R1, R2: 5.1k; R_0402_1005Metric
R3: 100k; R_0402_1005Metric
R4: 150k; R_0402_1005Metric
R5: 1M; R_0603_1608Metric
U1: USBLC6-2SC6; SOT-23-6; MPN USBLC6-2SC6

Connections:
/USB_D+: J1.A6 (D+), J1.B6 (D+), U1.3 (I/O2), U1.4 (I/O2); also elsewhere on the board
/USB_D-: J1.A7 (D-), J1.B7 (D-), U1.1 (I/O1), U1.6 (I/O1); also elsewhere on the board
/VBUS_DET: C3.1, R3.2, R4.1; also elsewhere on the board
unnamed: J1.A5 (CC1), R1.1
unnamed: J1.B5 (CC2), R2.1
unnamed: C4.1, J1.SH (SHIELD), R5.1

Notes on the sheet:
Shield RC to GND
VBUS DETECT: 0.6 x VBUS
USB-C DEVICE / USB 2.0
CC1 / CC2: independent 5.1k pull-downs
Input / ESD decoupling
Route D+/D- as 90 ohm differential pair; ESD close to J1.
USB 2.0: enable probe and radio only after host configuration.

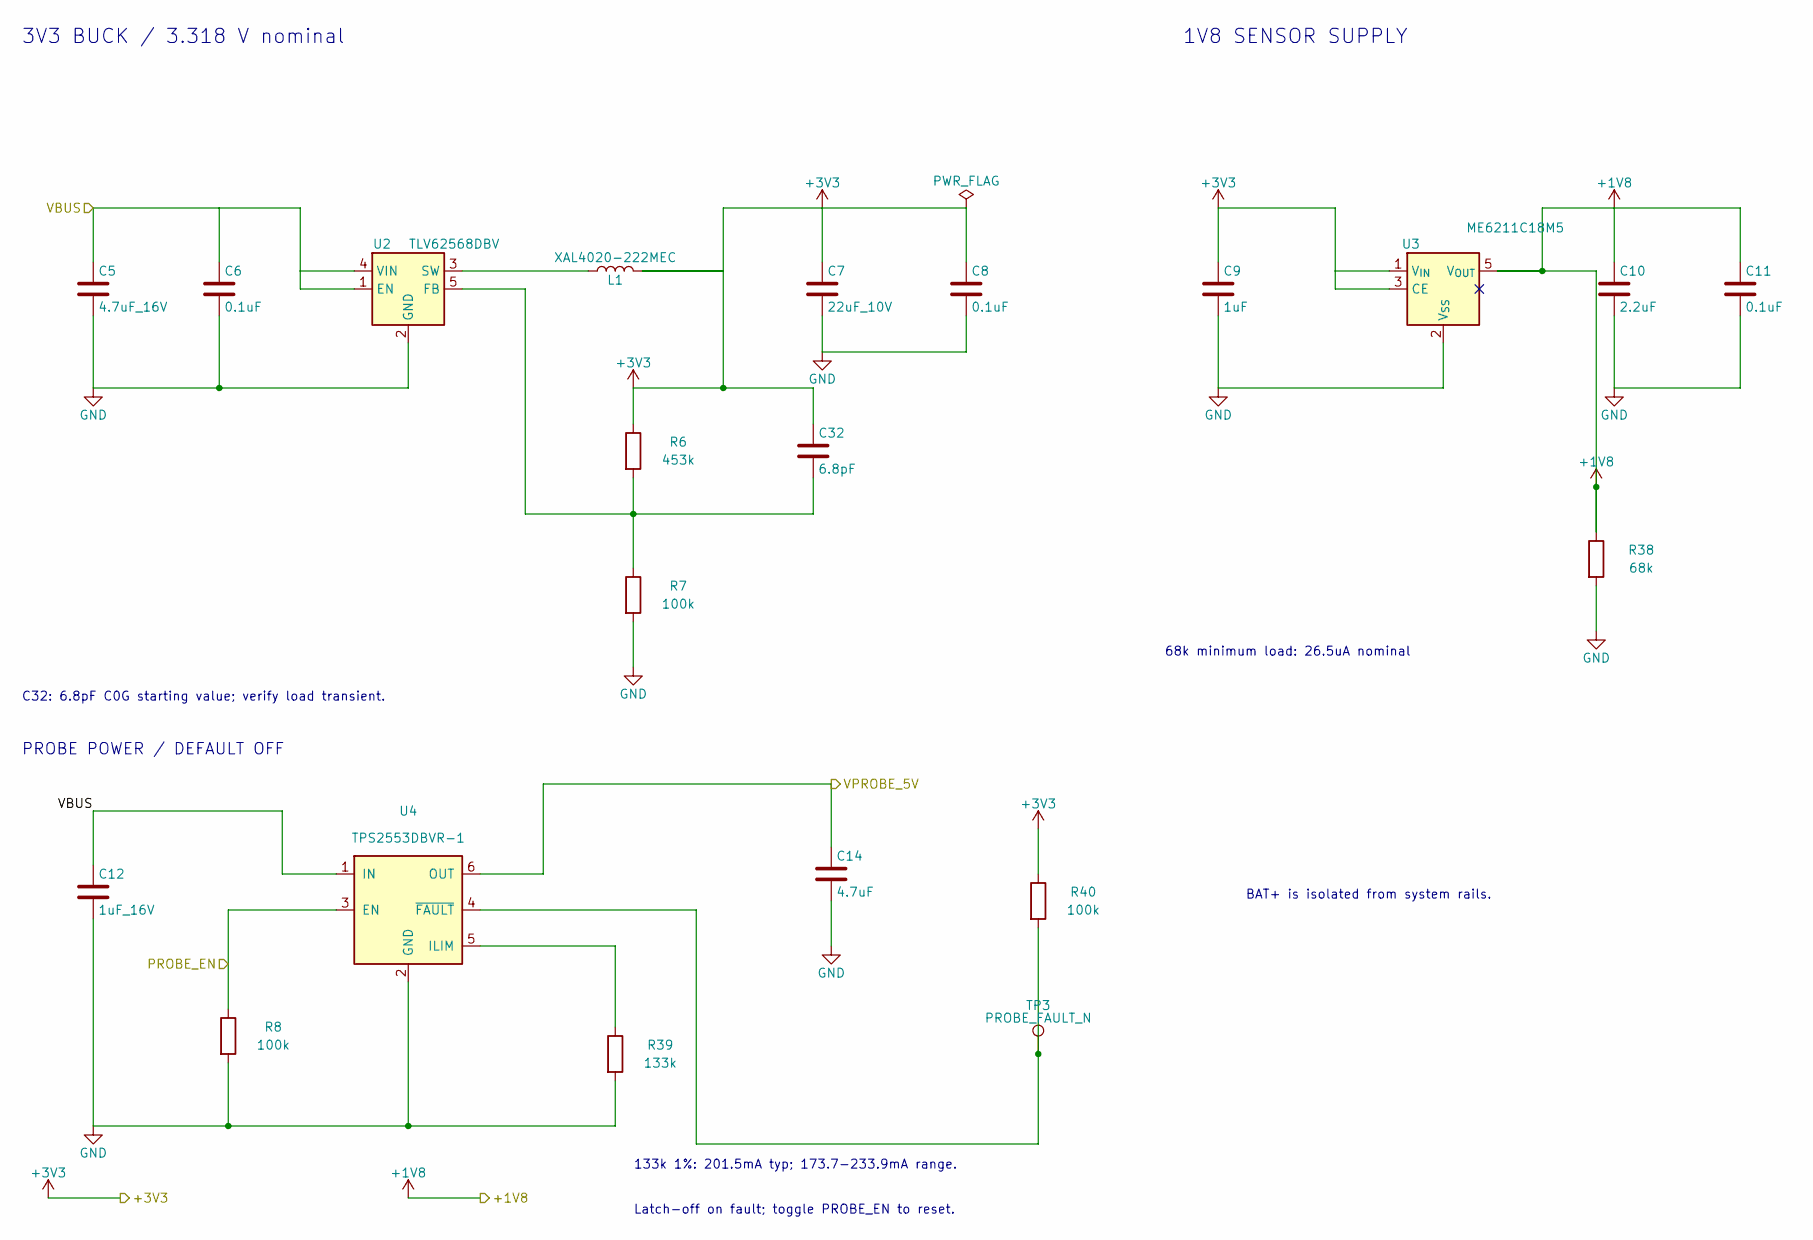
[picture p4: schematic 02_power.kicad_sch]

Parts:
C5: 4.7uF_16V; C_0805_2012Metric
C6, C8, C11: 0.1uF; C_0402_1005Metric
C7: 22uF_10V; C_0805_2012Metric
C9: 1uF; C_0402_1005Metric
C10: 2.2uF; C_0603_1608Metric
C12: 1uF_16V; C_0402_1005Metric
C14: 4.7uF; C_0603_1608Metric
C32: 6.8pF; C_0402_1005Metric; Tolerance 5%
L1: XAL4020-222MEC; L_Coilcraft_XAL4020-XXX
R6: 453k; R_0402_1005Metric
R7, R8, R40: 100k; R_0402_1005Metric
R38: 68k; R_0402_1005Metric; Tolerance 1%
R39: 133k; R_0402_1005Metric; Tolerance 1%
TP3: PROBE_FAULT_N; TestPoint_Pad_D1.0mm
U2: TLV62568DBV; SOT-23-5; MPN TLV62568DBVR
U3: ME6211C18M5; SOT-23-5; MPN ME6211C18M5
U4: TPS2553DBVR-1; SOT-23-6; MPN TPS2553DBVR-1

Connections:
+1V8: C10.1, C11.1, R38.1, U3.5 (V_{OUT}); also elsewhere on the board
+3V3: C7.1, C8.1, C9.1, C32.1, L1.2, R6.1, R40.1, U3.1 (V_{IN}), U3.3 (CE); also elsewhere on the board
/PROBE_EN: R8.1, U4.3 (EN); also elsewhere on the board
unnamed: C32.2, R6.2, R7.1, U2.5 (FB)
unnamed: L1.1, U2.3 (SW)
unnamed: R39.1, U4.5 (ILIM)
unnamed: R40.2, TP3.1 (1_1), U4.4 (~FAULT)
VPROBE_5V: C14.1, U4.6 (OUT); also elsewhere on the board

Notes on the sheet:
3V3 BUCK / 3.318 V nominal
BAT+ is isolated from system rails.
Latch-off on fault; toggle PROBE_EN to reset.
C32: 6.8pF C0G starting value; verify load transient.
PROBE POWER / DEFAULT OFF
133k 1%: 201.5mA typ; 173.7-233.9mA range.
68k minimum load: 26.5uA nominal
1V8 SENSOR SUPPLY

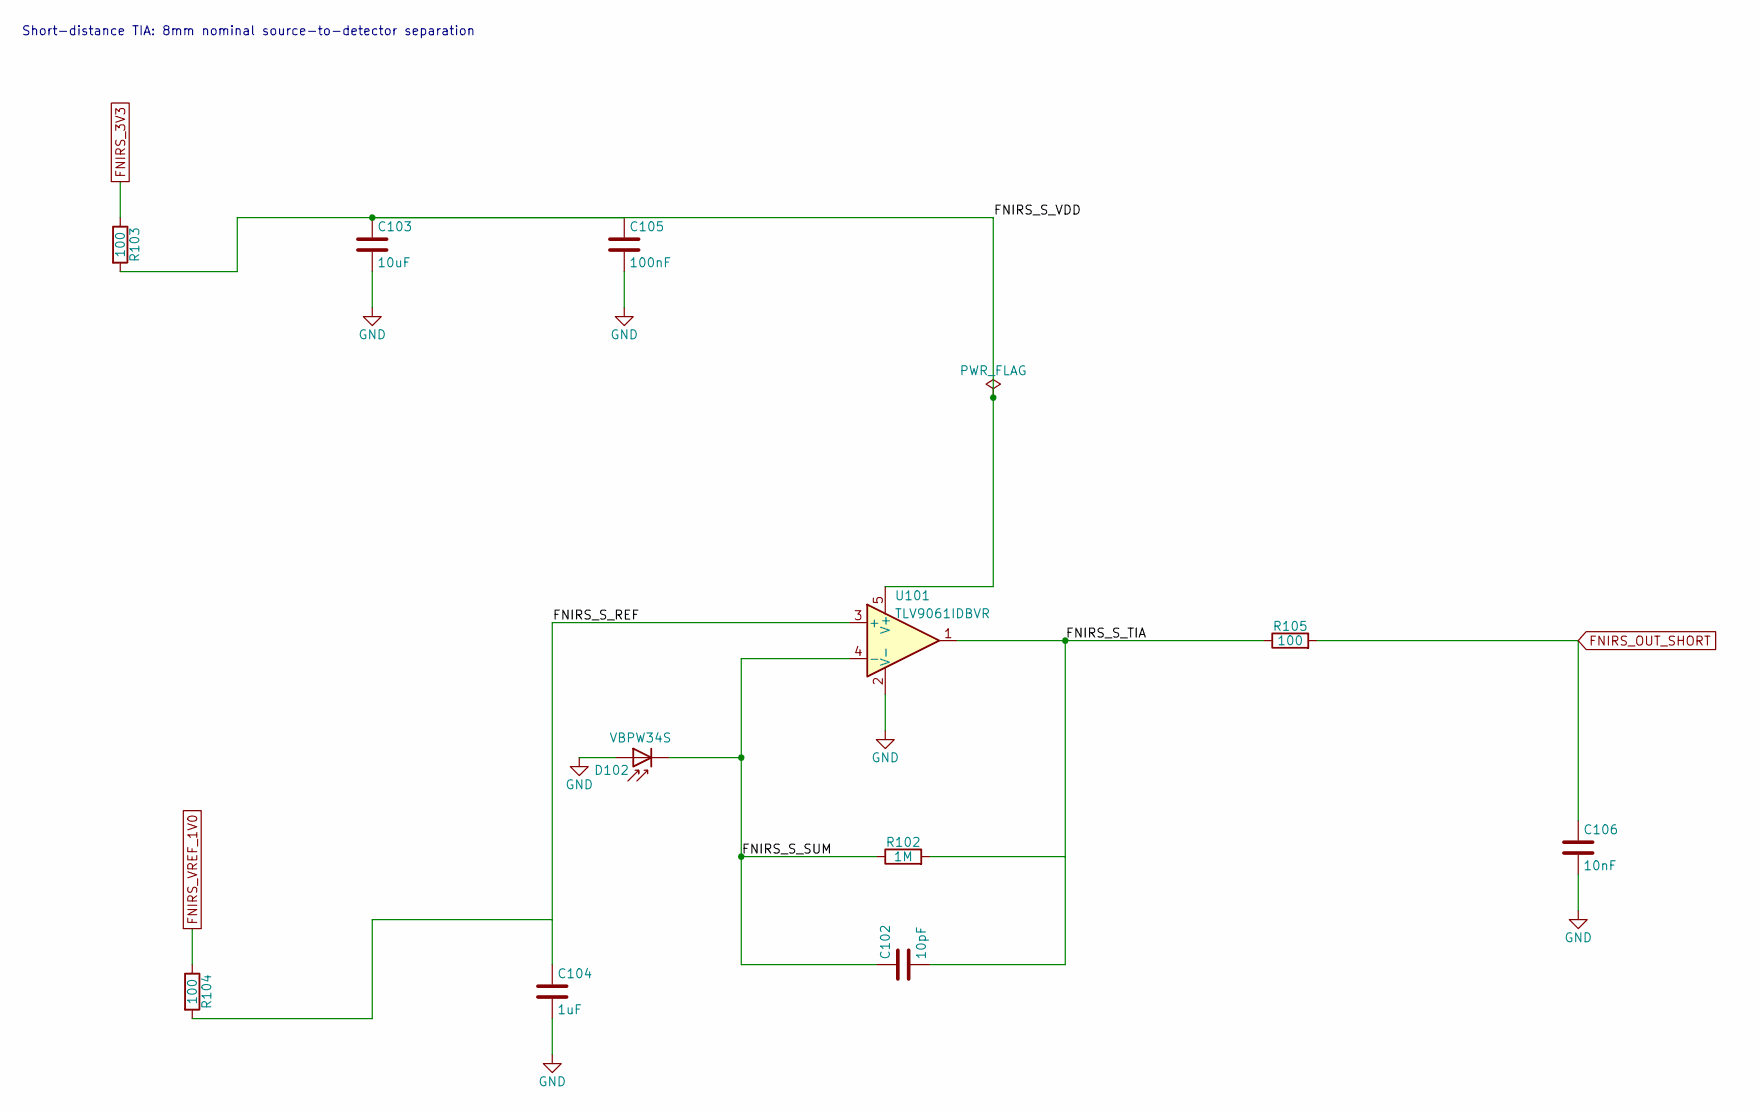
[picture p5: schematic 08_fnirs_short.kicad_sch]

Parts:
C102: 10pF; C_0603_1608Metric; MPN CL10C100JB8NNNC
C103: 10uF; C_0805_2012Metric; MPN CL21A106KAYNNNE
C104: 1uF; C_0603_1608Metric; MPN CL10A105KB8NNNC
C105: 100nF; C_0603_1608Metric; MPN CC0603KRX7R9BB104
C106: 10nF; C_0603_1608Metric; MPN 0603B103K500NT
D102: VBPW34S; VBPW34S_Normal_Gullwing; MPN VBPW34S
R102: 1M; R_0603_1608Metric; MPN 0603WAF1004T5E
R103, R104, R105: 100; R_0603_1608Metric; MPN 0603WAF1000T5E
U101: TLV9061IDBVR; SOT-23-5; MPN TLV9061IDBVR

Connections:
/08_FNIRS_SHORT/FNIRS_S_REF: C104.1, R104.2, U101.3 (+)
/08_FNIRS_SHORT/FNIRS_S_SUM: C102.1, D102.1 (K), R102.1, U101.4 (-)
/08_FNIRS_SHORT/FNIRS_S_TIA: C102.2, R102.2, R105.1, U101.1
/08_FNIRS_SHORT/FNIRS_S_VDD: C103.1, C105.1, R103.2, U101.5 (V+)
FNIRS_3V3: R103.1; also elsewhere on the board
FNIRS_OUT_SHORT: C106.1, R105.2; also elsewhere on the board
FNIRS_VREF_1V0: R104.1; also elsewhere on the board

Notes on the sheet:
Short-distance TIA: 8mm nominal source-to-detector separation

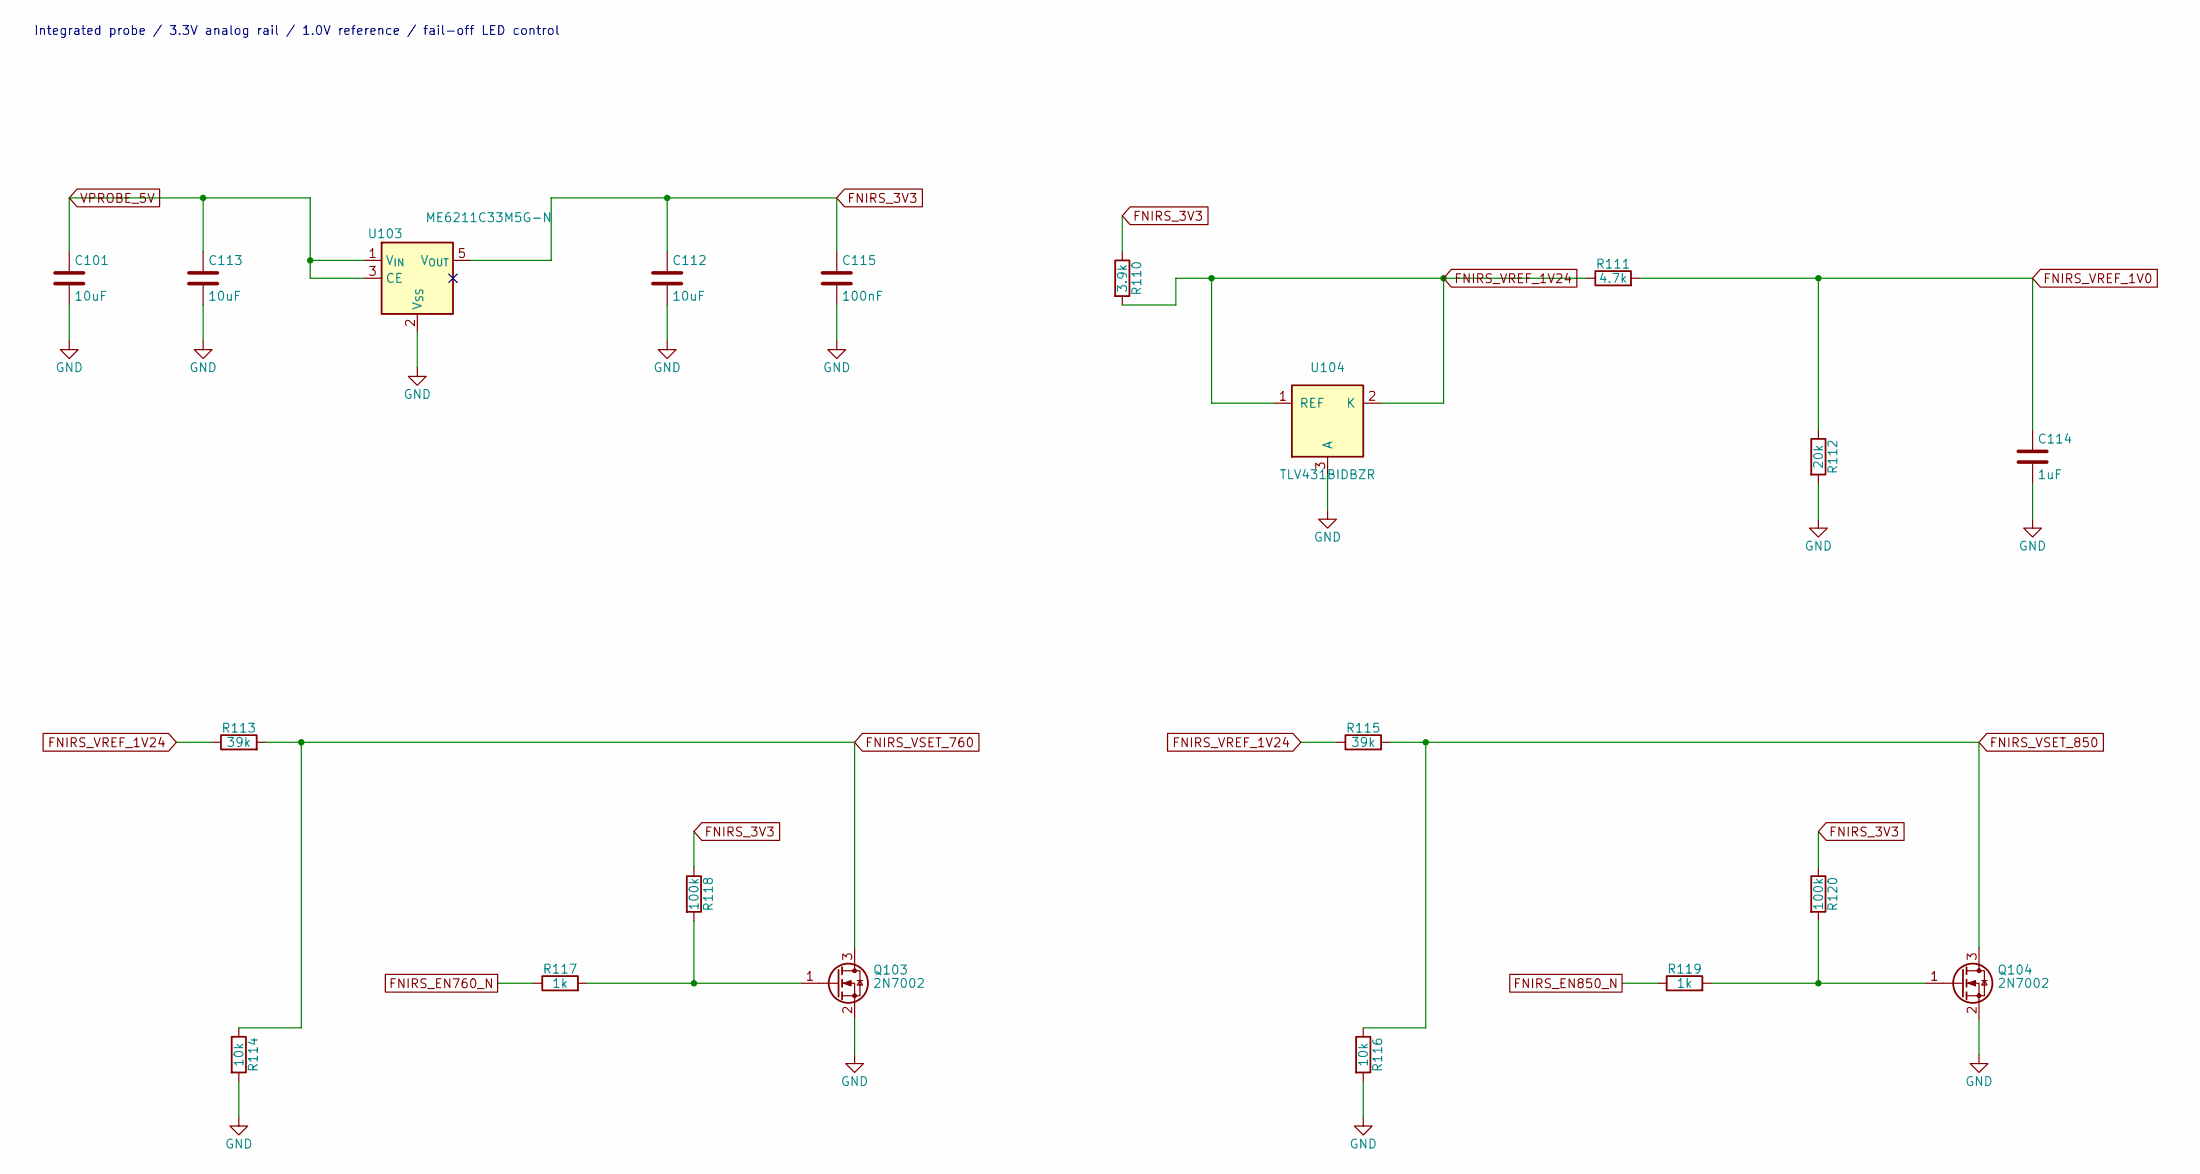
[picture p6: schematic 07_fnirs_power.kicad_sch]

Parts:
C101, C112, C113: 10uF; C_0805_2012Metric; MPN CL21A106KAYNNNE
C114: 1uF; C_0603_1608Metric; MPN CL10A105KB8NNNC
C115: 100nF; C_0603_1608Metric; MPN CL10B104KB8NNNC
Q103, Q104: 2N7002; SOT-23; MPN 2N7002
R110: 3.9k; R_0603_1608Metric; MPN 0603WAF3901T5E
R111: 4.7k; R_0603_1608Metric; MPN 0603WAF4701T5E
R112: 20k; R_0603_1608Metric; MPN 0603WAF2002T5E
R113, R115: 39k; R_0603_1608Metric; MPN 0603WAF3902T5E
R114, R116: 10k; R_0603_1608Metric; MPN 0603WAF1002T5E
R117, R119: 1k; R_0603_1608Metric; MPN 0603WAF1001T5E
R118, R120: 100k; R_0603_1608Metric; MPN 0603WAF1003T5E
U103: ME6211C33M5G-N; SOT-23-5; MPN ME6211C33M5G-N
U104: TLV431BIDBZR; SOT-23; MPN TLV431BIDBZR

Connections:
FNIRS_3V3: C112.1, C115.1, R110.1, R118.1, R120.1, U103.5 (V_{OUT}); also elsewhere on the board
FNIRS_EN760_N: R117.1; also elsewhere on the board
FNIRS_EN850_N: R119.1; also elsewhere on the board
FNIRS_VREF_1V0: C114.1, R111.2, R112.1; also elsewhere on the board
FNIRS_VREF_1V24: R110.2, R111.1, R113.1, R115.1, U104.1 (REF), U104.2 (K)
FNIRS_VSET_760: Q103.3 (D), R113.2, R114.1; also elsewhere on the board
FNIRS_VSET_850: Q104.3 (D), R115.2, R116.1; also elsewhere on the board
unnamed: Q103.1 (G), R117.2, R118.2
unnamed: Q104.1 (G), R119.2, R120.2
VPROBE_5V: C101.1, C113.1, U103.1 (V_{IN}), U103.3 (CE); also elsewhere on the board

Notes on the sheet:
Integrated probe / 3.3V analog rail / 1.0V reference / fail-off LED control

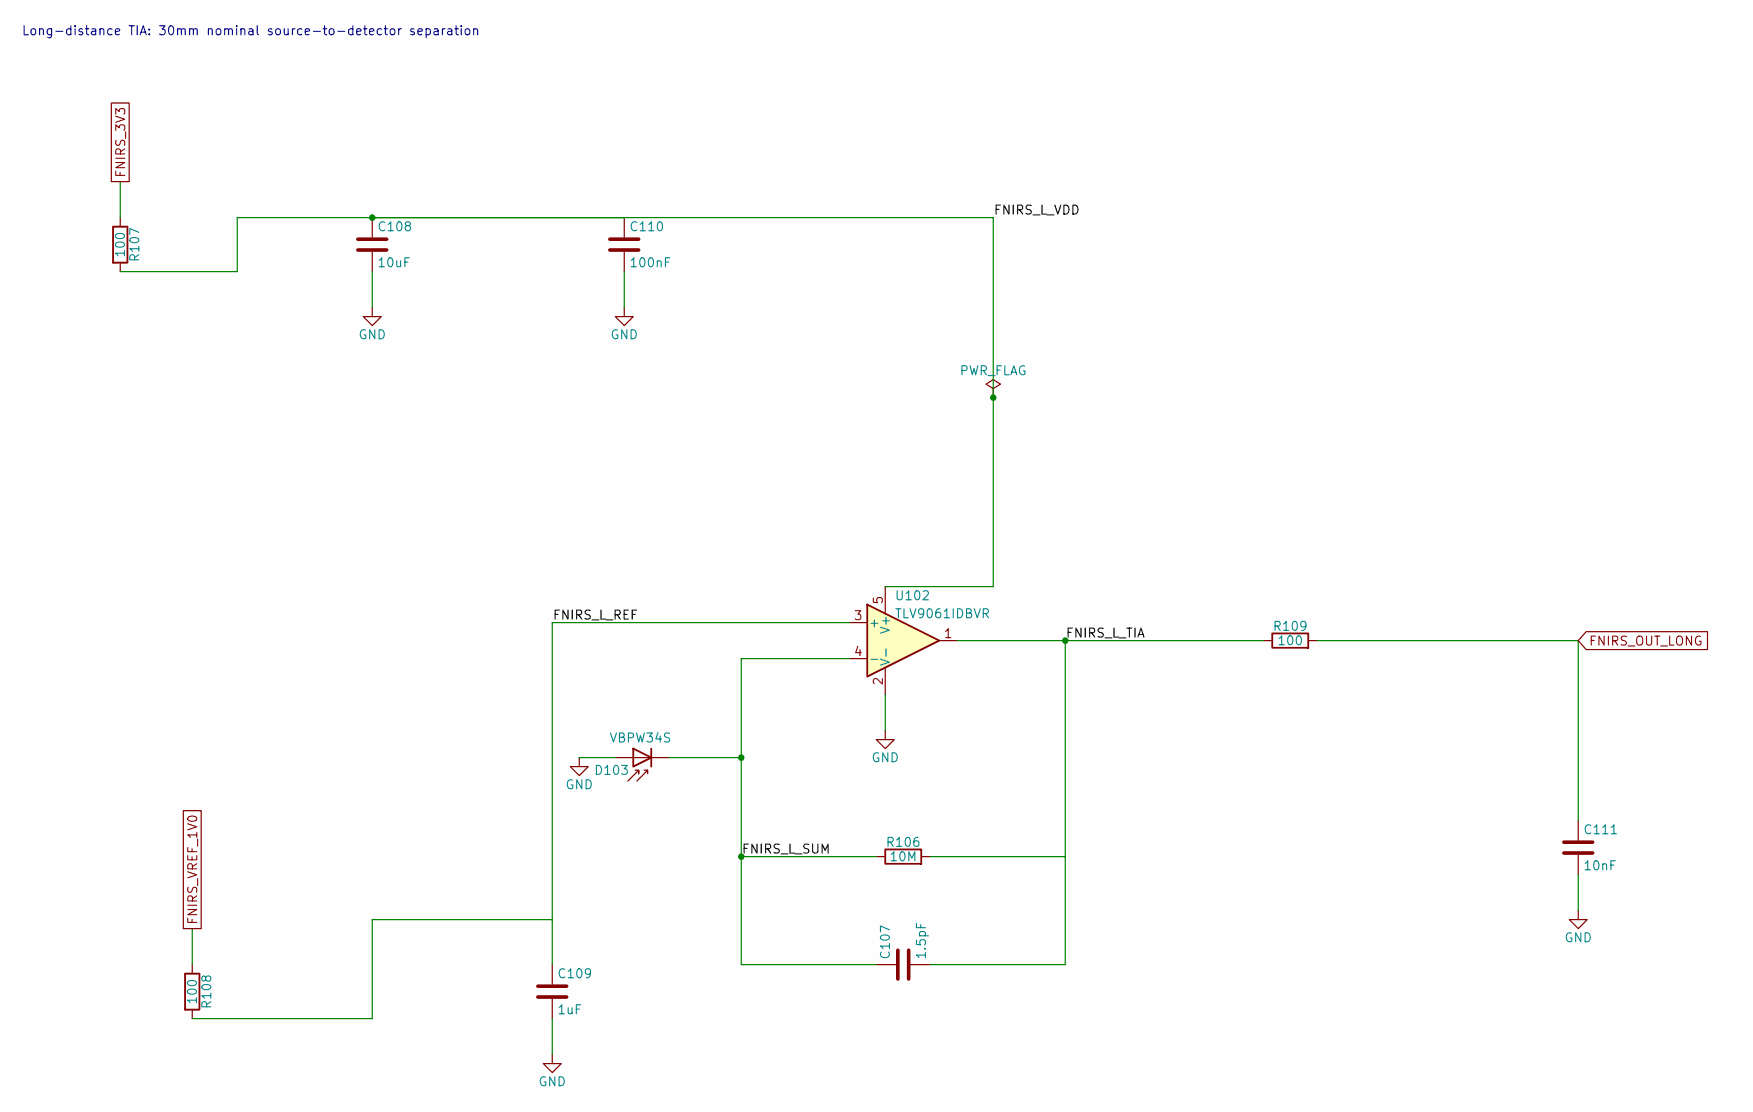
[picture p7: schematic 09_fnirs_long.kicad_sch]

Parts:
C107: 1.5pF; C_0603_1608Metric; MPN CL10C1R5BB8NNNC
C108: 10uF; C_0805_2012Metric; MPN CL21A106KAYNNNE
C109: 1uF; C_0603_1608Metric; MPN CL10A105KB8NNNC
C110: 100nF; C_0603_1608Metric; MPN CC0603KRX7R9BB104
C111: 10nF; C_0603_1608Metric; MPN 0603B103K500NT
D103: VBPW34S; VBPW34S_Normal_Gullwing; MPN VBPW34S
R106: 10M; R_0603_1608Metric; MPN 0603WAF1005T5E
R107, R108, R109: 100; R_0603_1608Metric; MPN 0603WAF1000T5E
U102: TLV9061IDBVR; SOT-23-5; MPN TLV9061IDBVR

Connections:
/09_FNIRS_LONG/FNIRS_L_REF: C109.1, R108.2, U102.3 (+)
/09_FNIRS_LONG/FNIRS_L_SUM: C107.1, D103.1 (K), R106.1, U102.4 (-)
/09_FNIRS_LONG/FNIRS_L_TIA: C107.2, R106.2, R109.1, U102.1
/09_FNIRS_LONG/FNIRS_L_VDD: C108.1, C110.1, R107.2, U102.5 (V+)
FNIRS_3V3: R107.1; also elsewhere on the board
FNIRS_OUT_LONG: C111.1, R109.2; also elsewhere on the board
FNIRS_VREF_1V0: R108.1; also elsewhere on the board

Notes on the sheet:
Long-distance TIA: 30mm nominal source-to-detector separation
