Yuna-Celisse/light-control/light-control.kicad_pcb

## KiCad design light-control.kicad_pcb (continued)

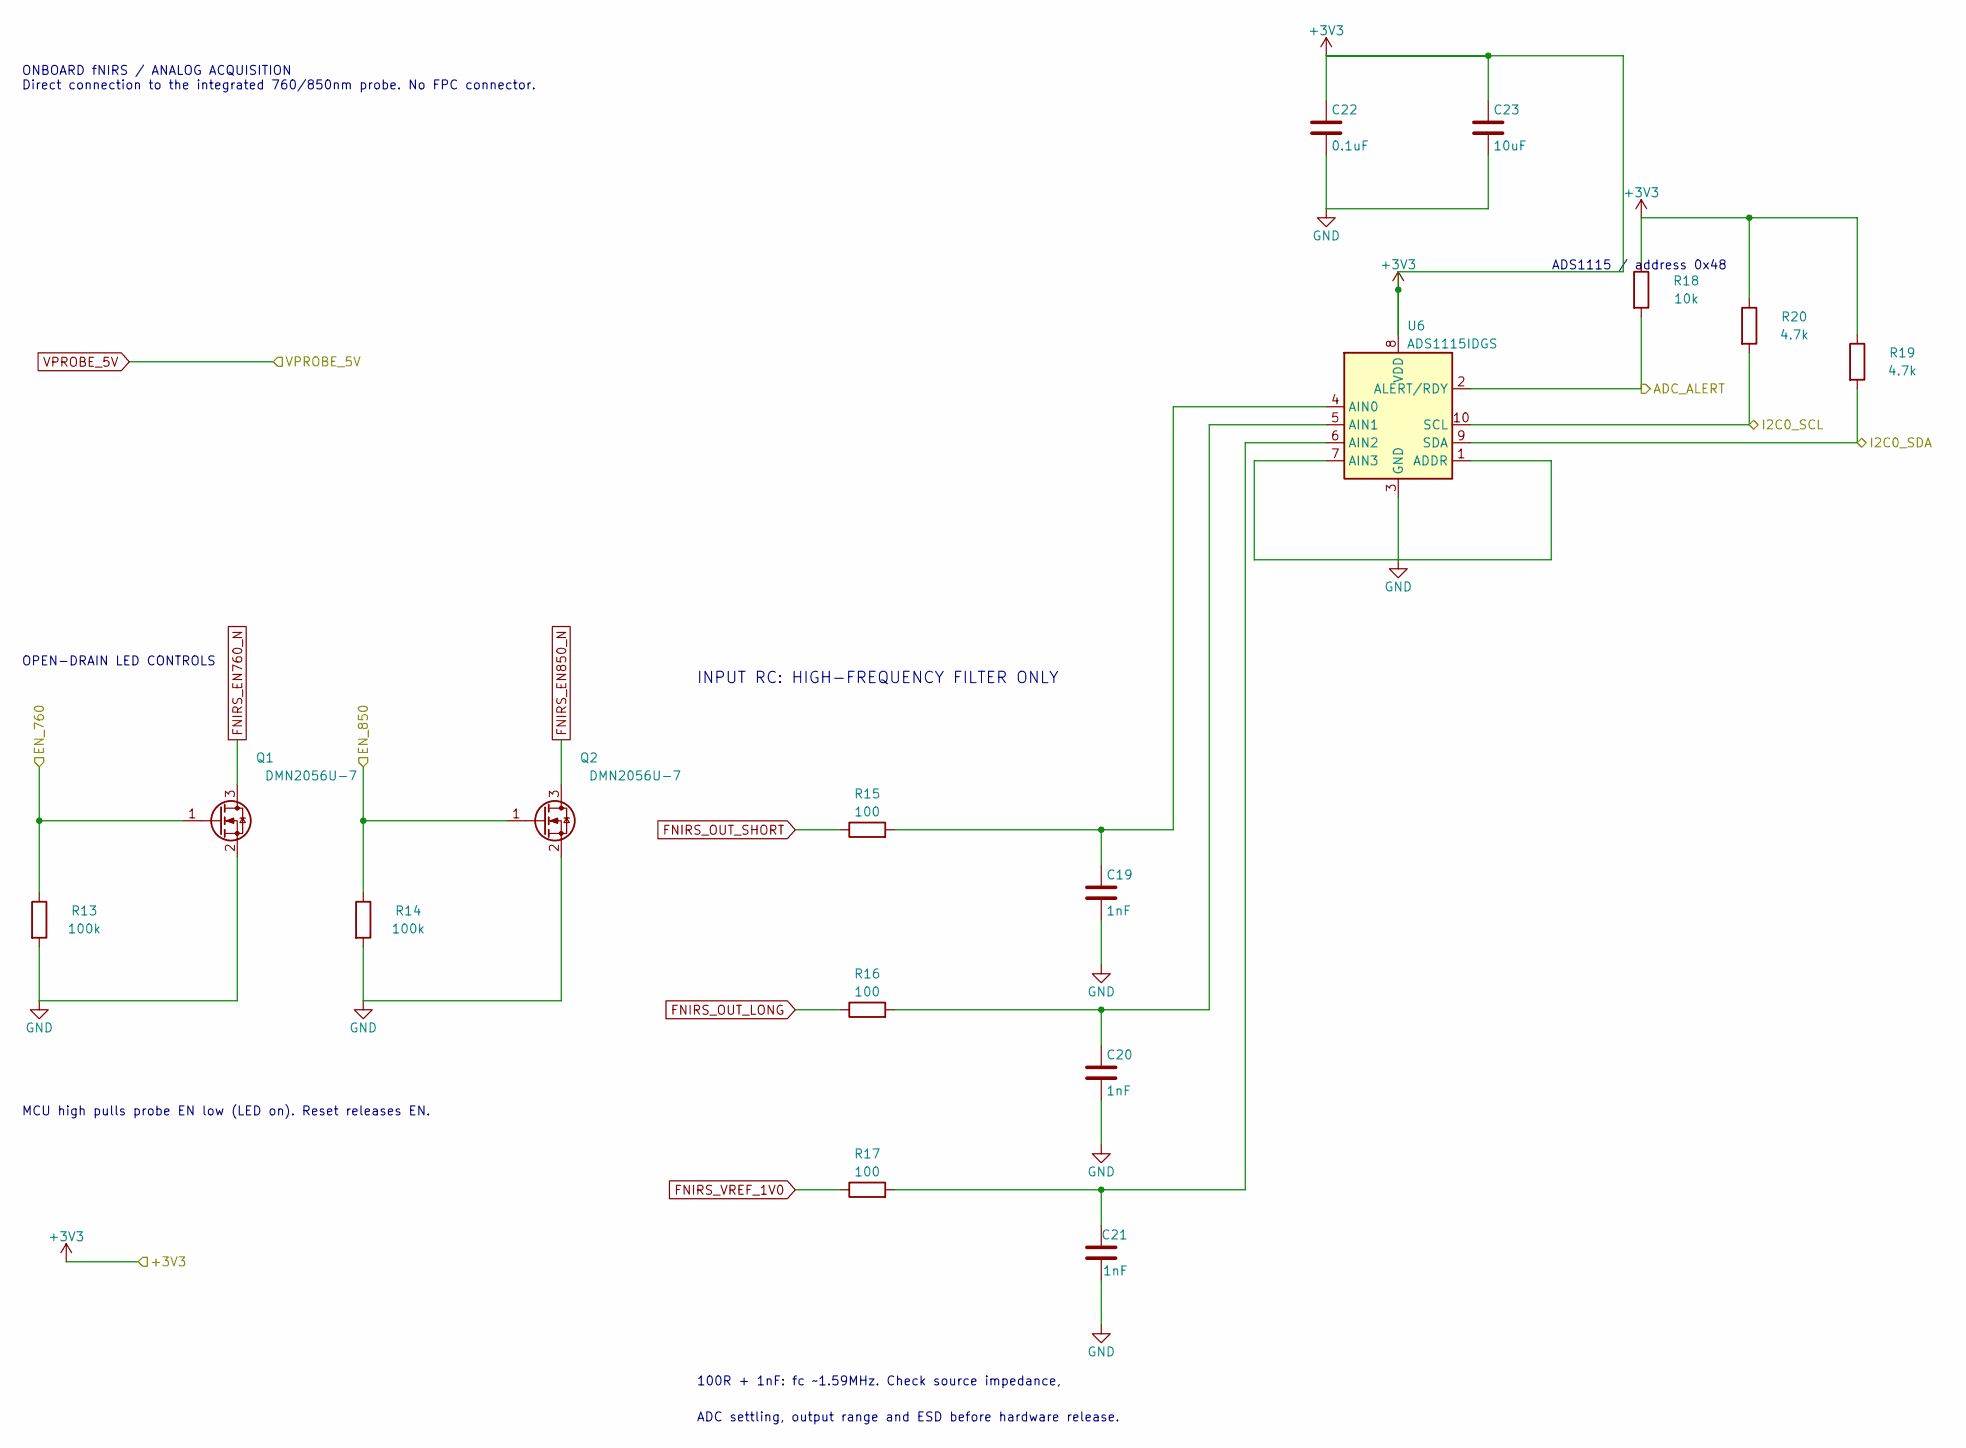
[picture p8: schematic 04_fpc_adc.kicad_sch]

Parts:
C19, C20, C21: 1nF; C_0402_1005Metric
C22: 0.1uF; C_0402_1005Metric
C23: 10uF; C_0805_2012Metric
Q1, Q2: DMN2056U-7; SOT-23; MPN DMN2056U-7
R13, R14: 100k; R_0402_1005Metric
R15, R16, R17: 100; R_0402_1005Metric
R18: 10k; R_0402_1005Metric
R19, R20: 4.7k; R_0402_1005Metric
U6: ADS1115IDGS; TSSOP-10_3x3mm_P0.5mm; MPN ADS1115IDGS

Connections:
+3V3: C22.1, C23.1, R18.1, R19.1, R20.1, U6.8 (VDD); also elsewhere on the board
/ADC_ALERT: R18.2, U6.2 (ALERT/RDY); also elsewhere on the board
/EN_760: Q1.1 (G), R13.1; also elsewhere on the board
/EN_850: Q2.1 (G), R14.1; also elsewhere on the board
/I2C0_SCL: R20.2, U6.10 (SCL); also elsewhere on the board
/I2C0_SDA: R19.2, U6.9 (SDA); also elsewhere on the board
FNIRS_EN760_N: Q1.3 (D); also elsewhere on the board
FNIRS_EN850_N: Q2.3 (D); also elsewhere on the board
FNIRS_OUT_LONG: R16.1; also elsewhere on the board
FNIRS_OUT_SHORT: R15.1; also elsewhere on the board
FNIRS_VREF_1V0: R17.1; also elsewhere on the board
unnamed: C19.1, R15.2, U6.4 (AIN0)
unnamed: C20.1, R16.2, U6.5 (AIN1)
unnamed: C21.2, R17.2, U6.6 (AIN2)

Notes on the sheet:
ADC settling, output range and ESD before hardware release.
ADS1115 / address 0x48
100R + 1nF: fc ~1.59MHz. Check source impedance,
INPUT RC: HIGH-FREQUENCY FILTER ONLY
MCU high pulls probe EN low (LED on). Reset releases EN.
ONBOARD fNIRS / ANALOG ACQUISITION Direct connection to the integrated 760/850nm probe. No FPC connector.
OPEN-DRAIN LED CONTROLS

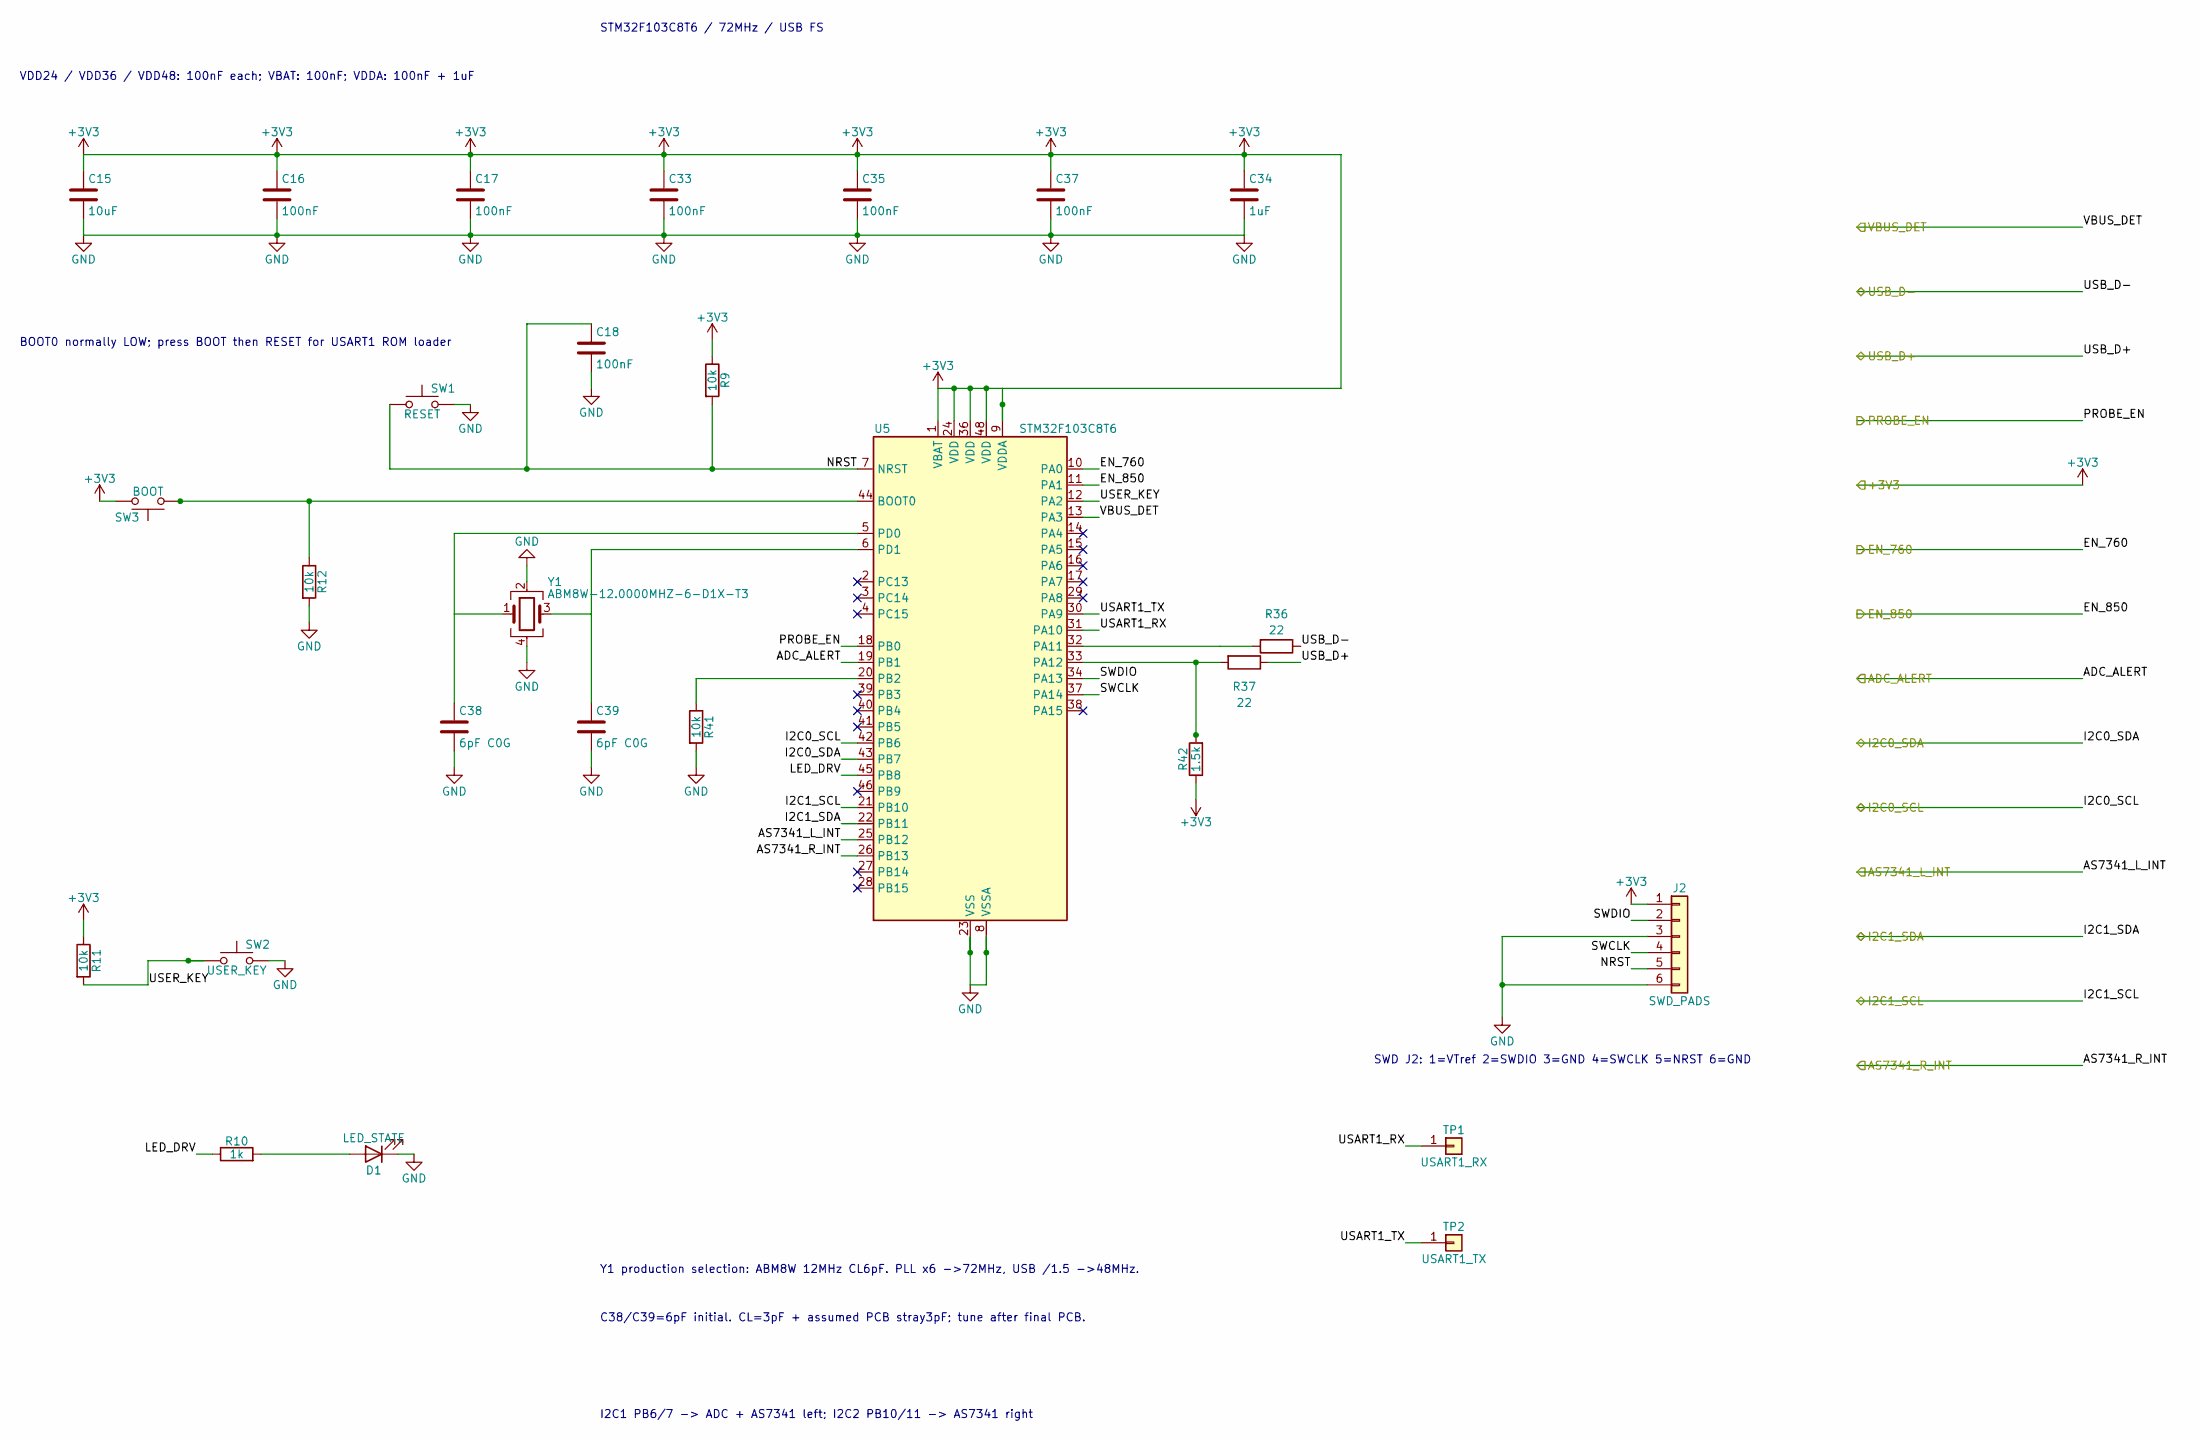
[picture p9: schematic 03_stm32f103.kicad_sch]

Parts:
C15: 10uF; C_0805_2012Metric
C16, C17, C18, C33, C35, C37: 100nF; C_0402_1005Metric
C34: 1uF; C_0402_1005Metric
C38, C39: 6pF C0G; C_0402_1005Metric
D1: LED_STATE; LED_0603_1608Metric
J2: SWD_PADS; SWD_SolderPads_1x06_P2.00mm
R9, R11, R12, R41: 10k; R_0402_1005Metric
R10: 1k; R_0402_1005Metric
R36, R37: 22; R_0402_1005Metric
R42: 1.5k; R_0402_1005Metric
SW1: RESET; SW_SPST_PTS645Sx43SMTR92
SW2: USER_KEY; SW_SPST_PTS645Sx43SMTR92
SW3: BOOT; SW_SPST_PTS645Sx43SMTR92
TP1: USART1_RX; TestPoint_Pad_D1.0mm
TP2: USART1_TX; TestPoint_Pad_D1.0mm
U5: STM32F103C8T6; LQFP-48_7x7mm_P0.5mm
Y1: ABM8W-12.0000MHZ-6-D1X-T3; Crystal_SMD_3225-4Pin_3.2x2.5mm; MPN ABM8W-12.0000MHZ-6-D1X-T3

Connections:
+3V3: C15.1, C16.1, C17.1, C33.1, C34.1, C35.1, C37.1, J2.1, R9.1, R11.1, R42.1, SW3.2, U5.1 (VBAT), U5.9 (VDDA), U5.24 (VDD), U5.36 (VDD), U5.48 (VDD); also elsewhere on the board
/03_STM32F103/LED_DRV: R10.1, U5.45 (PB8)
/03_STM32F103/NRST: C18.1, J2.5, R9.2, SW1.1, U5.7 (NRST)
/03_STM32F103/SWCLK: J2.4, U5.37 (PA14)
/03_STM32F103/SWDIO: J2.2, U5.34 (PA13)
/03_STM32F103/USART1_RX: TP1.1 (Pin_1_1), U5.31 (PA10)
/03_STM32F103/USART1_TX: TP2.1 (Pin_1_1), U5.30 (PA9)
/03_STM32F103/USER_KEY: R11.2, SW2.1, U5.12 (PA2)
/ADC_ALERT: U5.19 (PB1); also elsewhere on the board
/AS7341_L_INT: U5.25 (PB12); also elsewhere on the board
/AS7341_R_INT: U5.26 (PB13); also elsewhere on the board
/EN_760: U5.10 (PA0); also elsewhere on the board
/EN_850: U5.11 (PA1); also elsewhere on the board
/I2C0_SCL: U5.42 (PB6); also elsewhere on the board
/I2C0_SDA: U5.43 (PB7); also elsewhere on the board
/I2C1_SCL: U5.21 (PB10); also elsewhere on the board
/I2C1_SDA: U5.22 (PB11); also elsewhere on the board
/PROBE_EN: U5.18 (PB0); also elsewhere on the board
/USB_D+: R37.1; also elsewhere on the board
/USB_D-: R36.1; also elsewhere on the board
/VBUS_DET: U5.13 (PA3); also elsewhere on the board
unnamed: D1.2 (A), R10.2
unnamed: R12.1, SW3.1, U5.44 (BOOT0)
unnamed: R36.2, U5.32 (PA11)
unnamed: R37.2, R42.2, U5.33 (PA12)
unnamed: R41.1, U5.20 (PB2)
unnamed: C38.1, U5.5 (PD0), Y1.1
unnamed: C39.1, U5.6 (PD1), Y1.3

Notes on the sheet:
STM32F103C8T6 / 72MHz / USB FS
VDD24 / VDD36 / VDD48: 100nF each; VBAT: 100nF; VDDA: 100nF + 1uF
BOOT0 normally LOW; press BOOT then RESET for USART1 ROM loader
I2C1 PB6/7 -> ADC + AS7341 left; I2C2 PB10/11 -> AS7341 right
SWD J2: 1=VTref 2=SWDIO 3=GND 4=SWCLK 5=NRST 6=GND
Y1 production selection: ABM8W 12MHz CL6pF. PLL x6 ->72MHz, USB /1.5 ->48MHz.
C38/C39=6pF initial. CL=3pF + assumed PCB stray3pF; tune after final PCB.

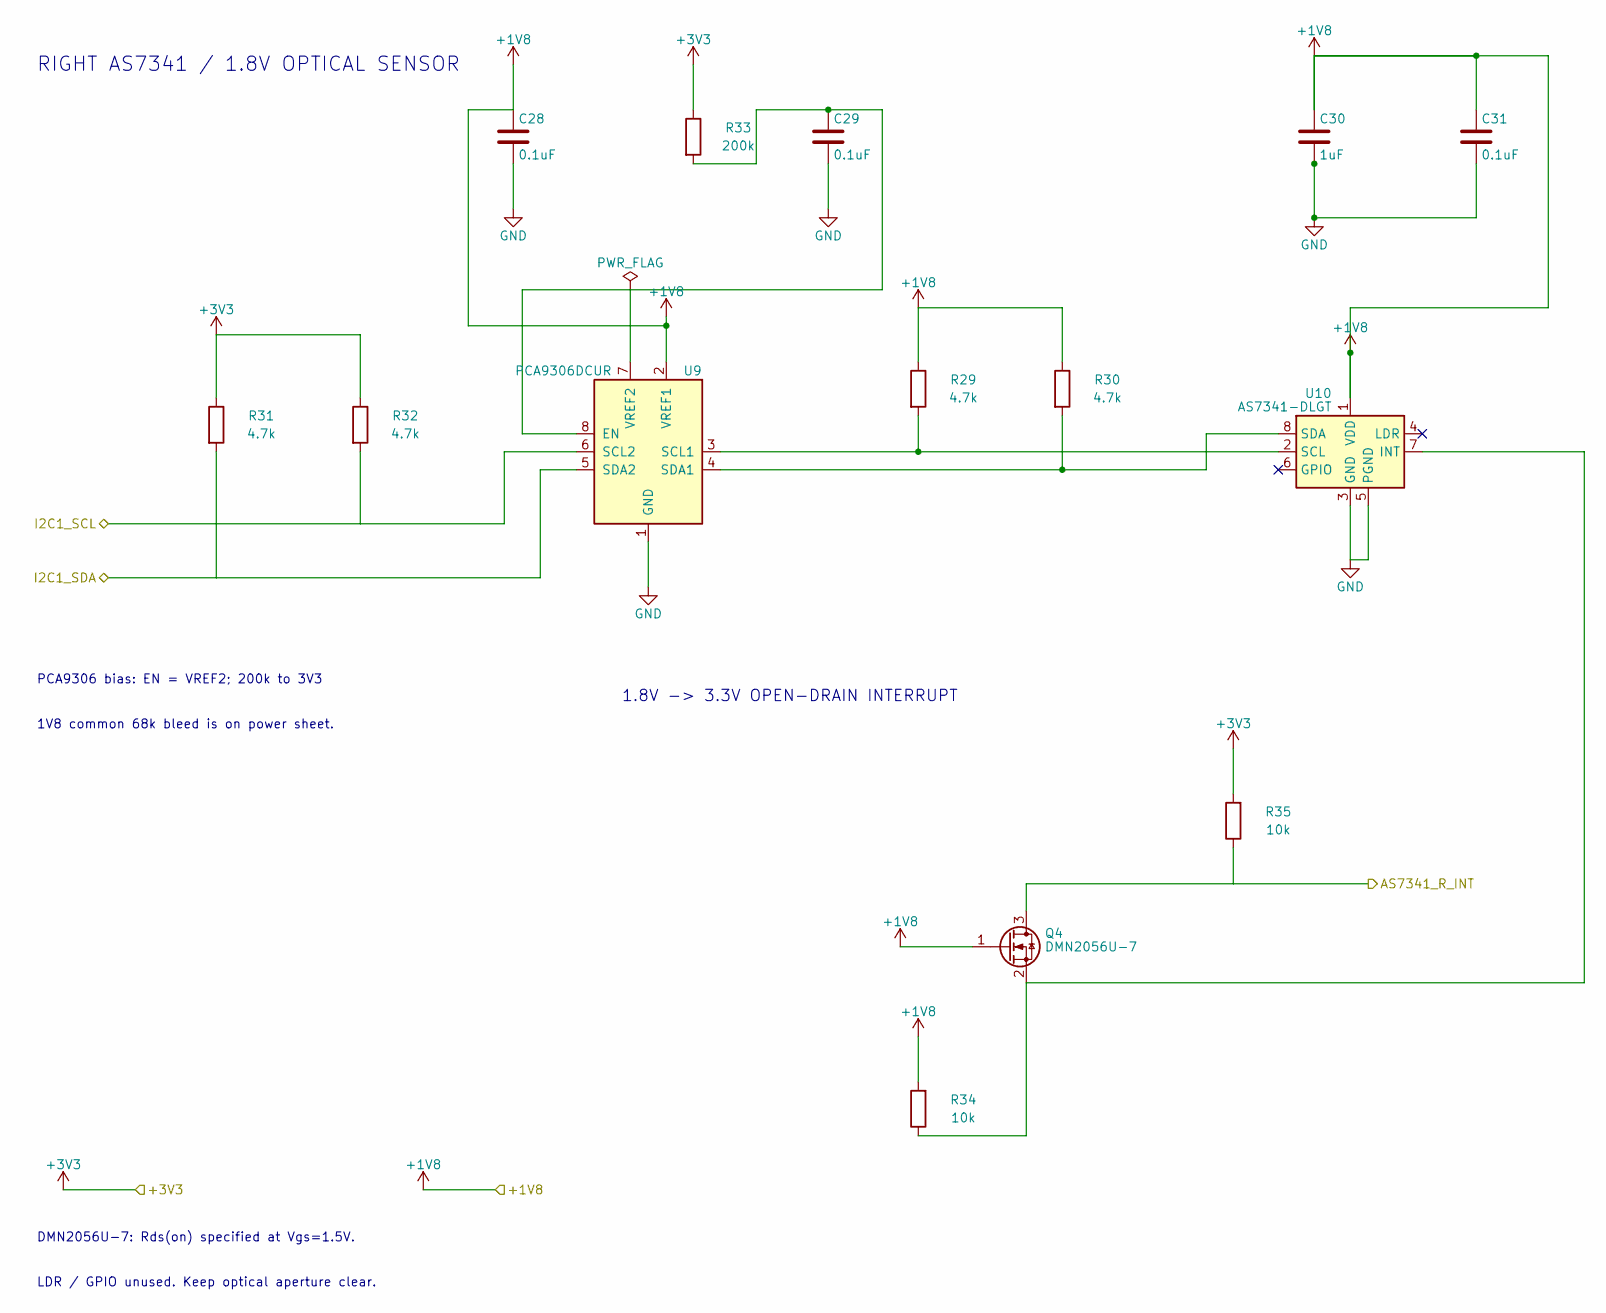
[picture p10: schematic 06_as7341_right.kicad_sch]

Parts:
C28, C29, C31: 0.1uF; C_0402_1005Metric
C30: 1uF; C_0402_1005Metric
Q4: DMN2056U-7; SOT-23; MPN DMN2056U-7
R29, R30, R31, R32: 4.7k; R_0402_1005Metric
R33: 200k; R_0402_1005Metric; Tolerance 1%
R34, R35: 10k; R_0402_1005Metric
U9: PCA9306DCUR; VSSOP-8_2.3x2mm_P0.5mm; MPN PCA9306DCUR
U10: AS7341-DLGT; AMS_OLGA-8_2x3.1mm_P0.8mm; MPN AS7341-DLGT

Connections:
+1V8: C28.1, C30.1, C31.1, Q4.1 (G), R29.1, R30.1, R34.2, U9.2 (VREF1), U10.1 (VDD); also elsewhere on the board
+3V3: R31.1, R32.1, R33.1, R35.2; also elsewhere on the board
/AS7341_R_INT: Q4.3 (D), R35.1; also elsewhere on the board
/I2C1_SCL: R32.2, U9.6 (SCL2); also elsewhere on the board
/I2C1_SDA: R31.2, U9.5 (SDA2); also elsewhere on the board
unnamed: Q4.2 (S), R34.1, U10.7 (INT)
unnamed: C29.1, R33.2, U9.7 (VREF2), U9.8 (EN)
unnamed: R29.2, U9.3 (SCL1), U10.2 (SCL)
unnamed: R30.2, U9.4 (SDA1), U10.8 (SDA)

Notes on the sheet:
PCA9306 bias: EN = VREF2; 200k to 3V3
DMN2056U-7: Rds(on) specified at Vgs=1.5V.
1.8V -> 3.3V OPEN-DRAIN INTERRUPT
RIGHT AS7341 / 1.8V OPTICAL SENSOR
1V8 common 68k bleed is on power sheet.
LDR / GPIO unused. Keep optical aperture clear.

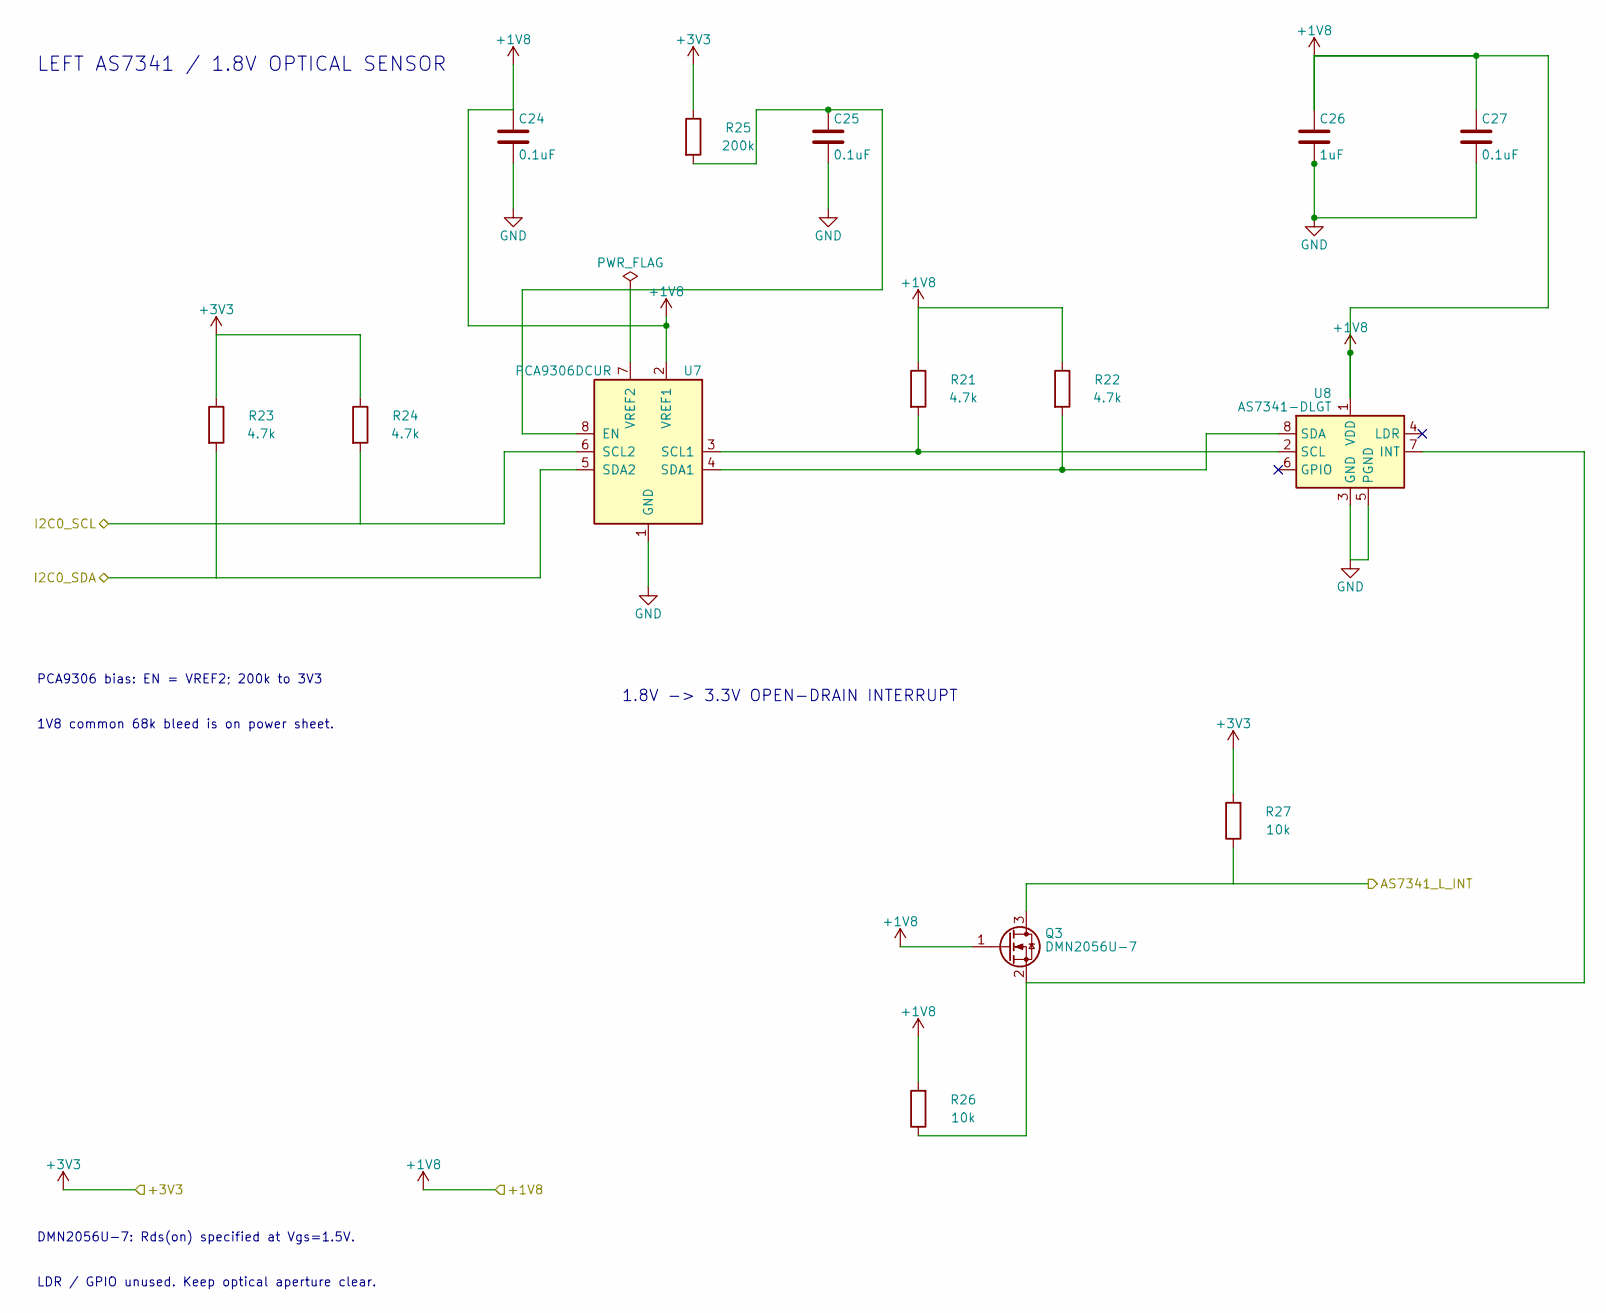
[picture p11: schematic 05_as7341_left.kicad_sch]

Parts:
C24, C25, C27: 0.1uF; C_0402_1005Metric
C26: 1uF; C_0402_1005Metric
Q3: DMN2056U-7; SOT-23; MPN DMN2056U-7
R21, R22, R23, R24: 4.7k; R_0402_1005Metric
R25: 200k; R_0402_1005Metric; Tolerance 1%
R26, R27: 10k; R_0402_1005Metric
U7: PCA9306DCUR; VSSOP-8_2.3x2mm_P0.5mm; MPN PCA9306DCUR
U8: AS7341-DLGT; AMS_OLGA-8_2x3.1mm_P0.8mm; MPN AS7341-DLGT

Connections:
+1V8: C24.1, C26.1, C27.1, Q3.1 (G), R21.1, R22.1, R26.2, U7.2 (VREF1), U8.1 (VDD); also elsewhere on the board
+3V3: R23.1, R24.1, R25.1, R27.2; also elsewhere on the board
/AS7341_L_INT: Q3.3 (D), R27.1; also elsewhere on the board
/I2C0_SCL: R24.2, U7.6 (SCL2); also elsewhere on the board
/I2C0_SDA: R23.2, U7.5 (SDA2); also elsewhere on the board
unnamed: Q3.2 (S), R26.1, U8.7 (INT)
unnamed: C25.1, R25.2, U7.7 (VREF2), U7.8 (EN)
unnamed: R21.2, U7.3 (SCL1), U8.2 (SCL)
unnamed: R22.2, U7.4 (SDA1), U8.8 (SDA)

Notes on the sheet:
LDR / GPIO unused. Keep optical aperture clear.
1.8V -> 3.3V OPEN-DRAIN INTERRUPT
DMN2056U-7: Rds(on) specified at Vgs=1.5V.
PCA9306 bias: EN = VREF2; 200k to 3V3
1V8 common 68k bleed is on power sheet.
LEFT AS7341 / 1.8V OPTICAL SENSOR

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
Board: 4 copper layers, 164 parts (60 on the bottom side), 79 nets, no tracks yet.
