Yuna-Celisse/light-control/(commit log)

2026-11-10 Publish KiCad light-control project and design review
    [01_usb_protect.kicad_sch, 02_power.kicad_sch, 03_esp32_s3_qfn.kicad_sch, 04_fpc_adc.kicad_sch, 05_as7341_left.kicad_sch, 06_as7341_right.kicad_sch, 07_fnirs_power.kicad_sch, 08_fnirs_short.kicad_sch]
2026-11-10 SWD焊盘待调整、线路全部移除
    [01_usb_protect.kicad_sch, 02_power.kicad_sch, 03_stm32f103.kicad_sch, 04_fpc_adc.kicad_sch, 05_as7341_left.kicad_sch, 06_as7341_right.kicad_sch, 07_fnirs_power.kicad_sch, 08_fnirs_short.kicad_sch]
